Iwetter/Mimic-Animatronic-Head/renders/layers/PL01_layers.png

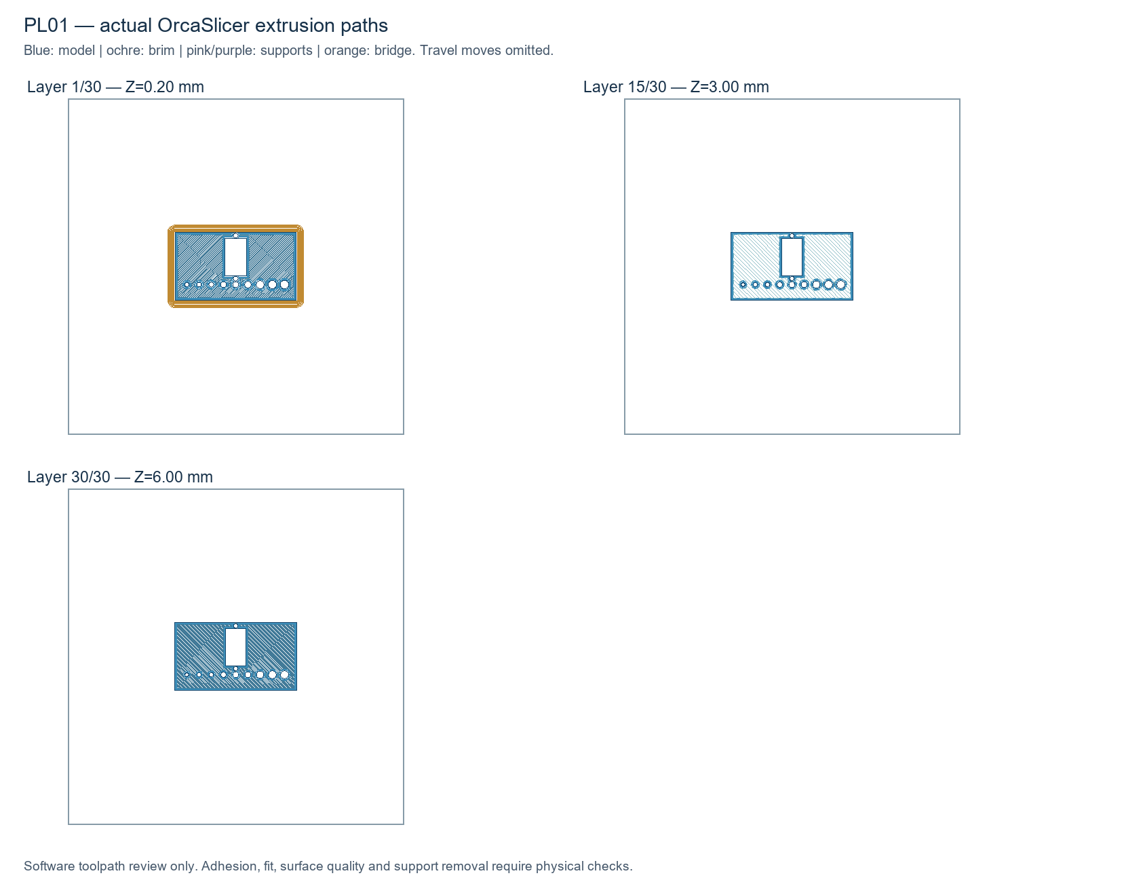
renders/layers/PL01_layers.png
