Iwetter/Mimic-Animatronic-Head/renders/layers/PL02_layers.png

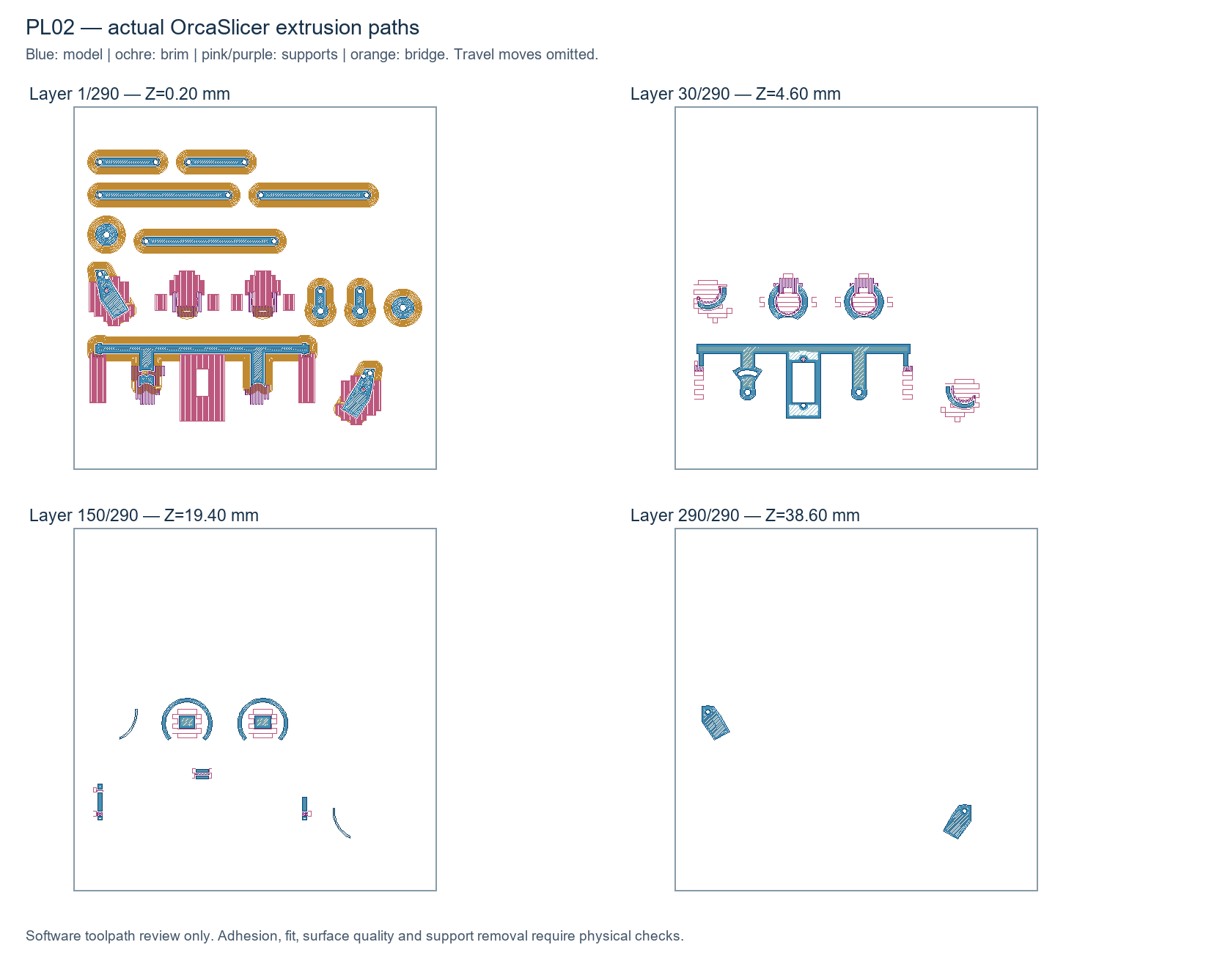
renders/layers/PL02_layers.png
