Iwetter/Mimic-Animatronic-Head/renders/layers/PL03_layers.png

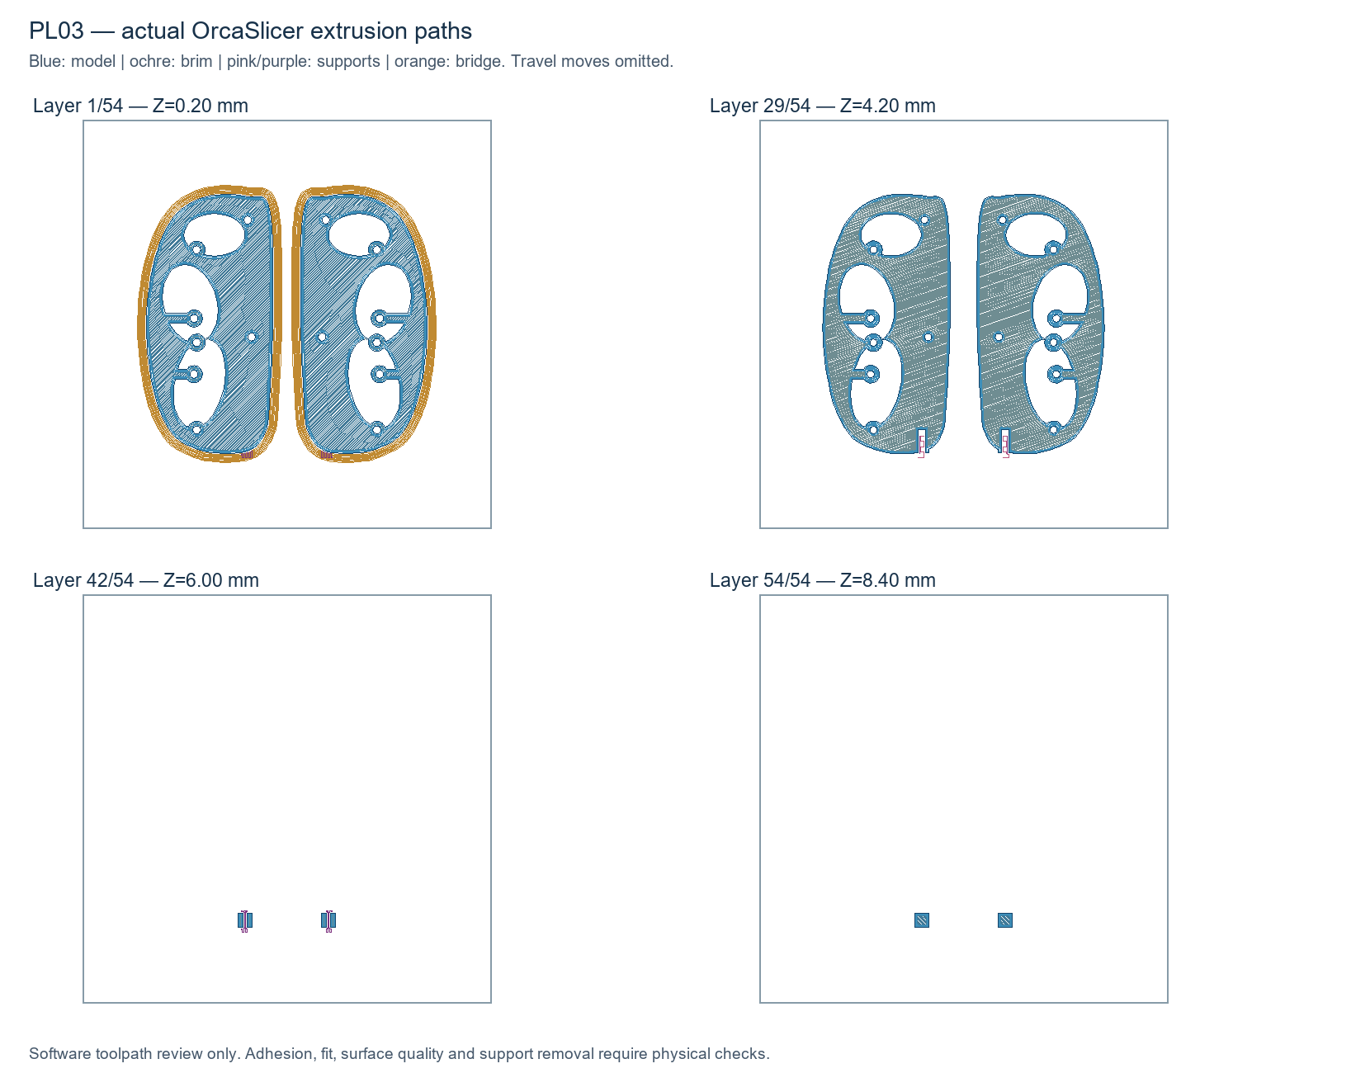
renders/layers/PL03_layers.png
