Iwetter/Mimic-Animatronic-Head/renders/layers/PL04_layers.png

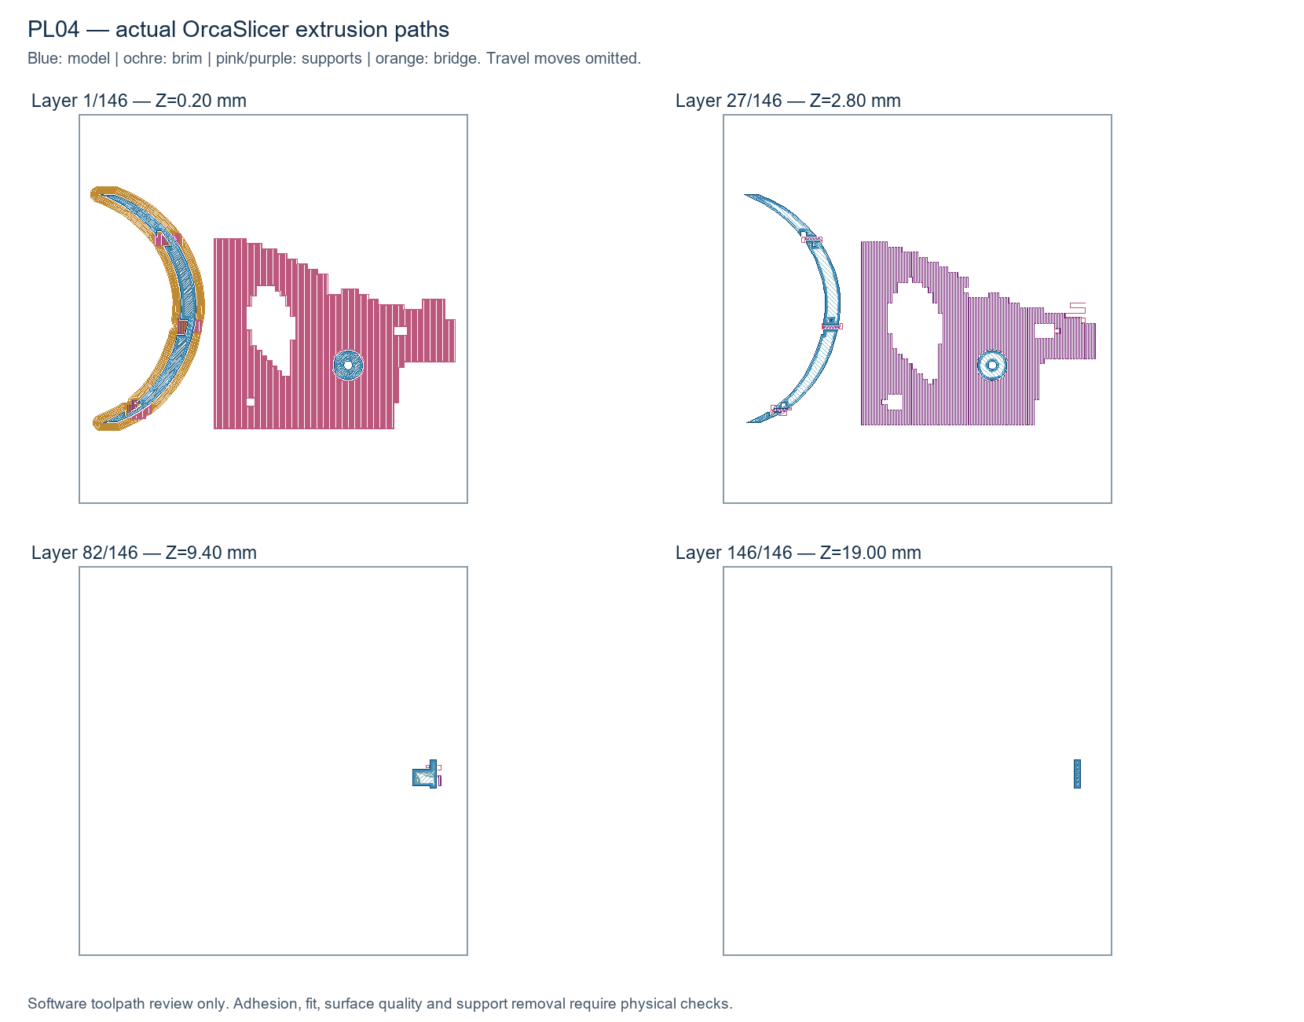
renders/layers/PL04_layers.png
