Iwetter/Mimic-Animatronic-Head/renders/layers/PL05_layers.png

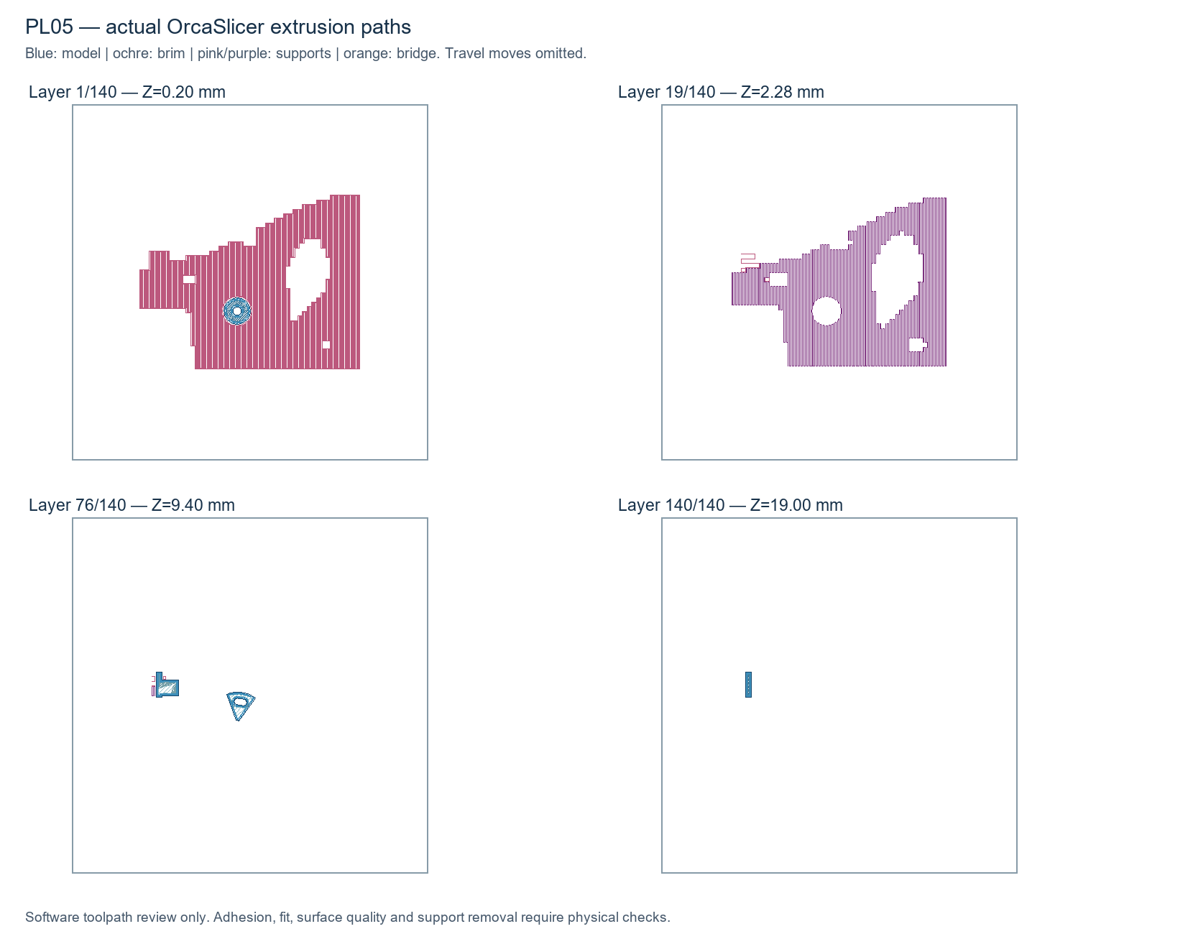
renders/layers/PL05_layers.png
