Iwetter/Mimic-Animatronic-Head/renders/layers/PL06_layers.png

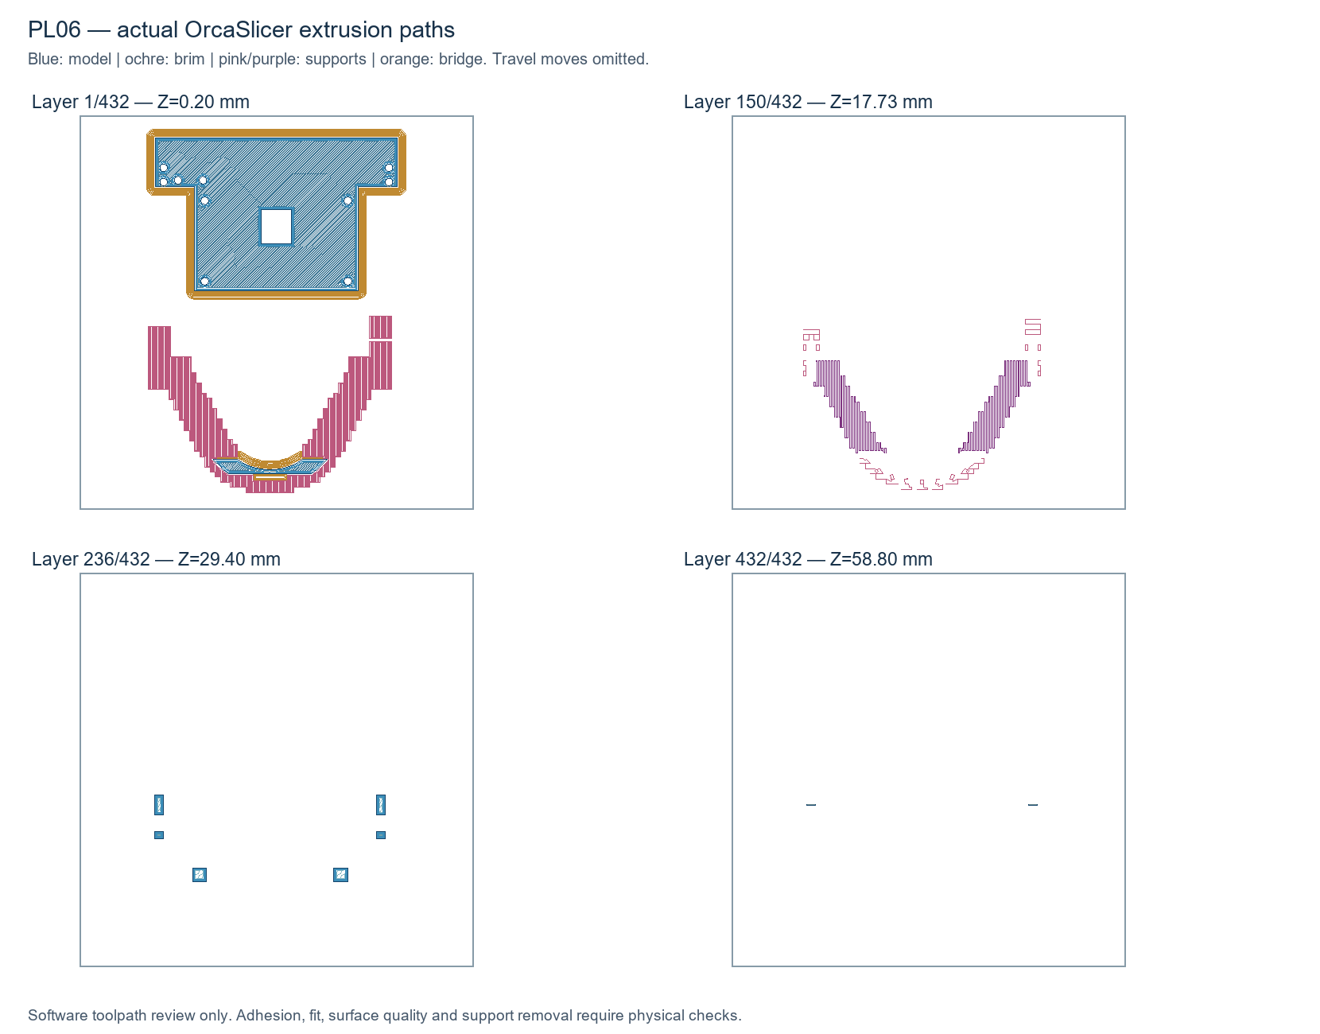
renders/layers/PL06_layers.png
