Iwetter/Mimic-Animatronic-Head/renders/layers/PL07_layers.png

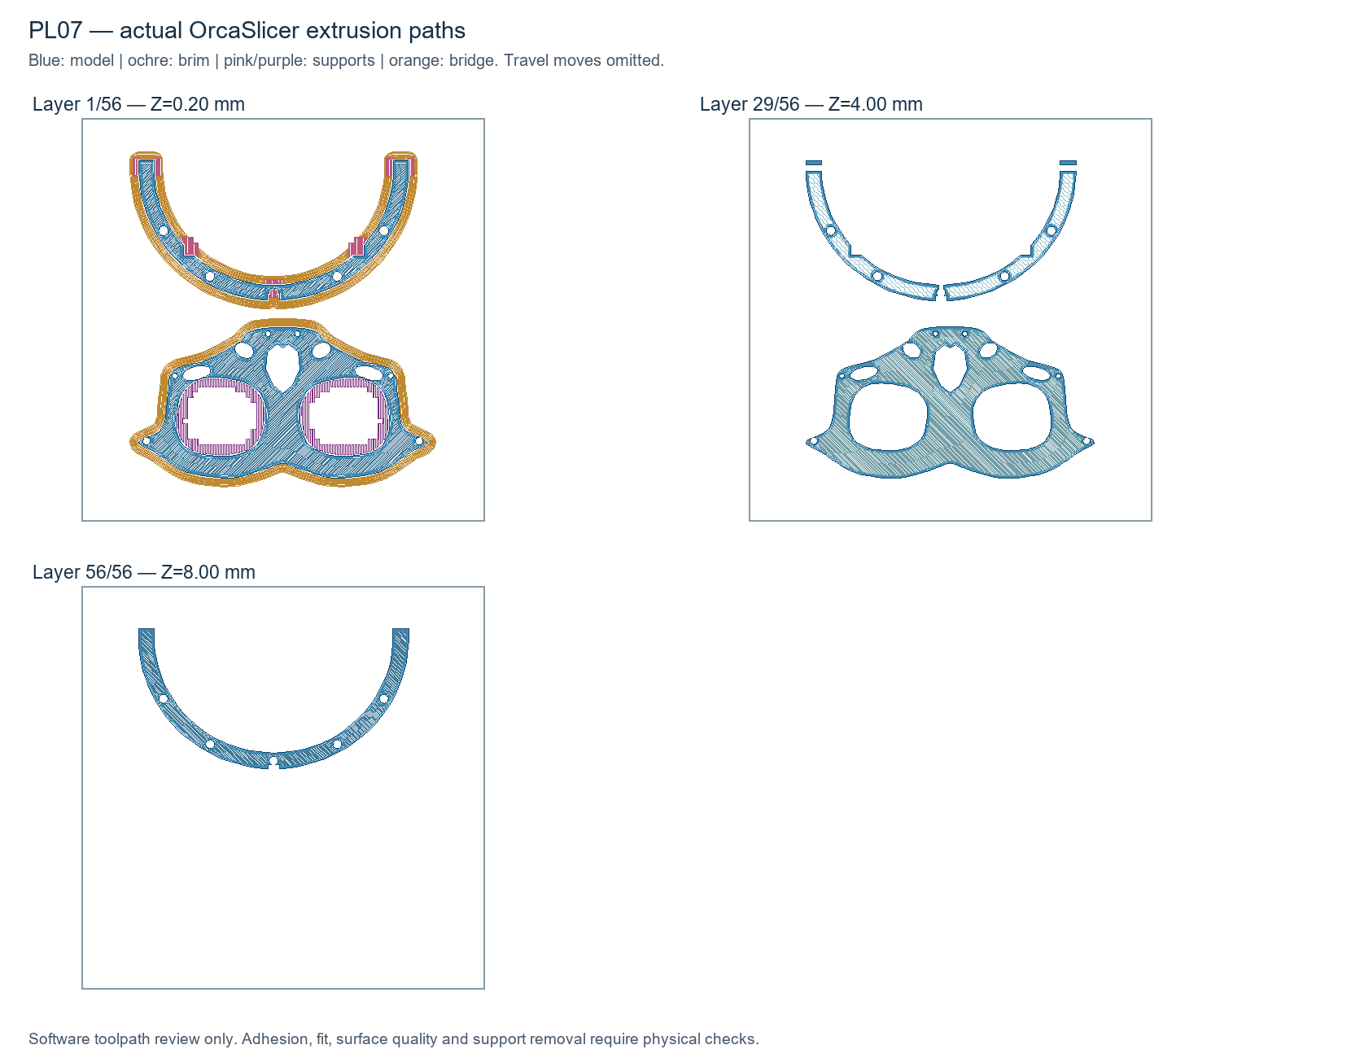
renders/layers/PL07_layers.png
