Iwetter/Mimic-Animatronic-Head/renders/layers/PL08_layers.png

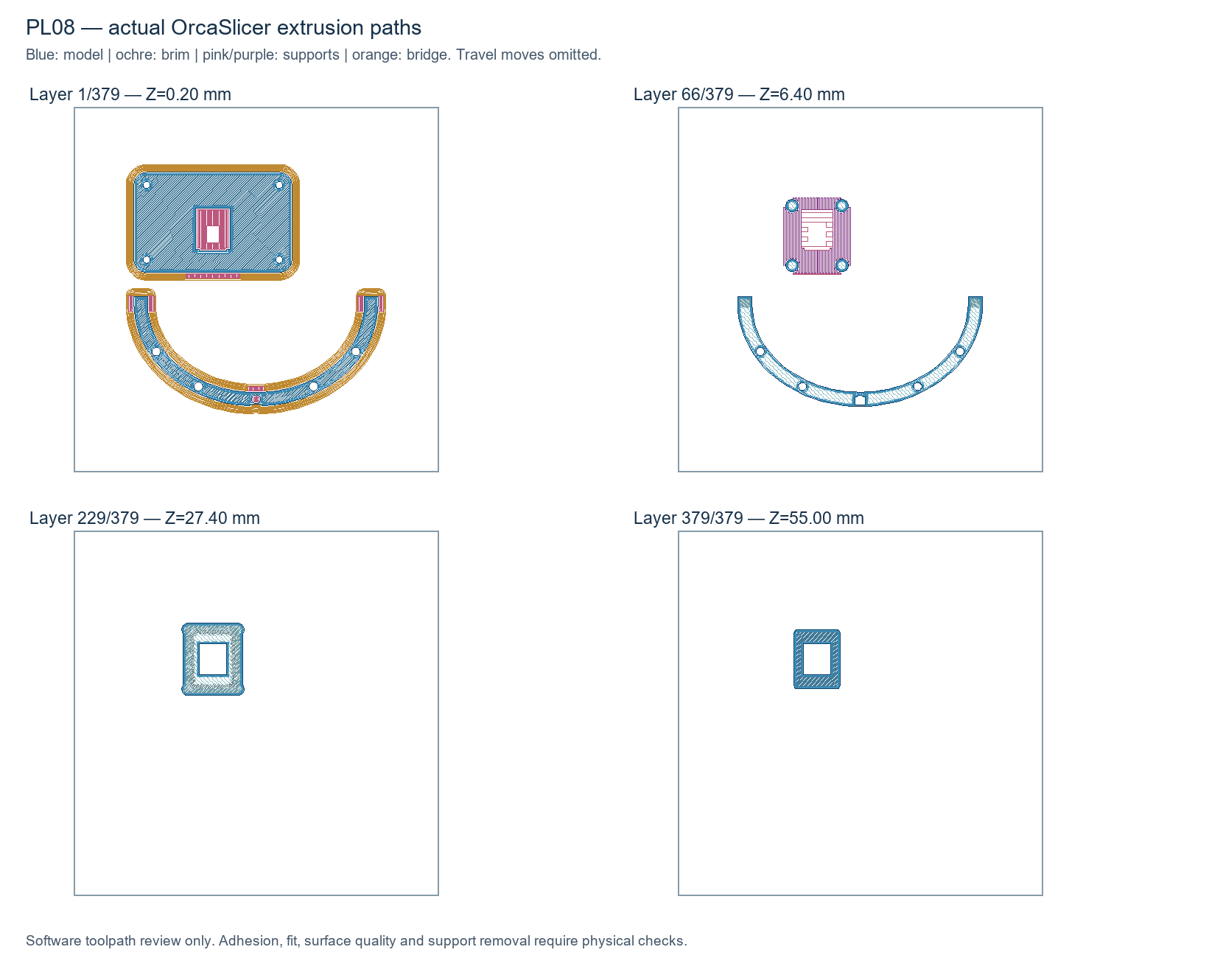
renders/layers/PL08_layers.png
