Iwetter/Mimic-Animatronic-Head/renders/layers/PL09_layers.png

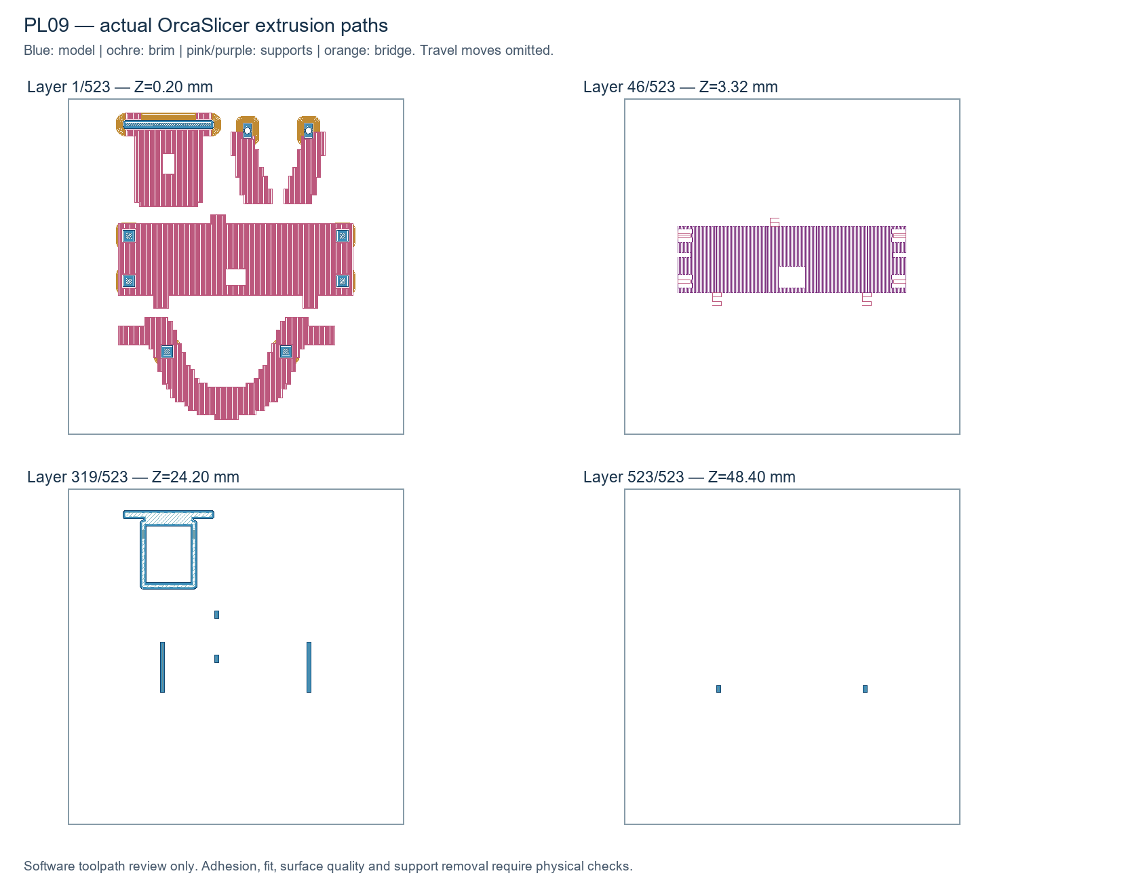
renders/layers/PL09_layers.png
