Iwetter/Mimic-Animatronic-Head/renders/layers/PL10_layers.png

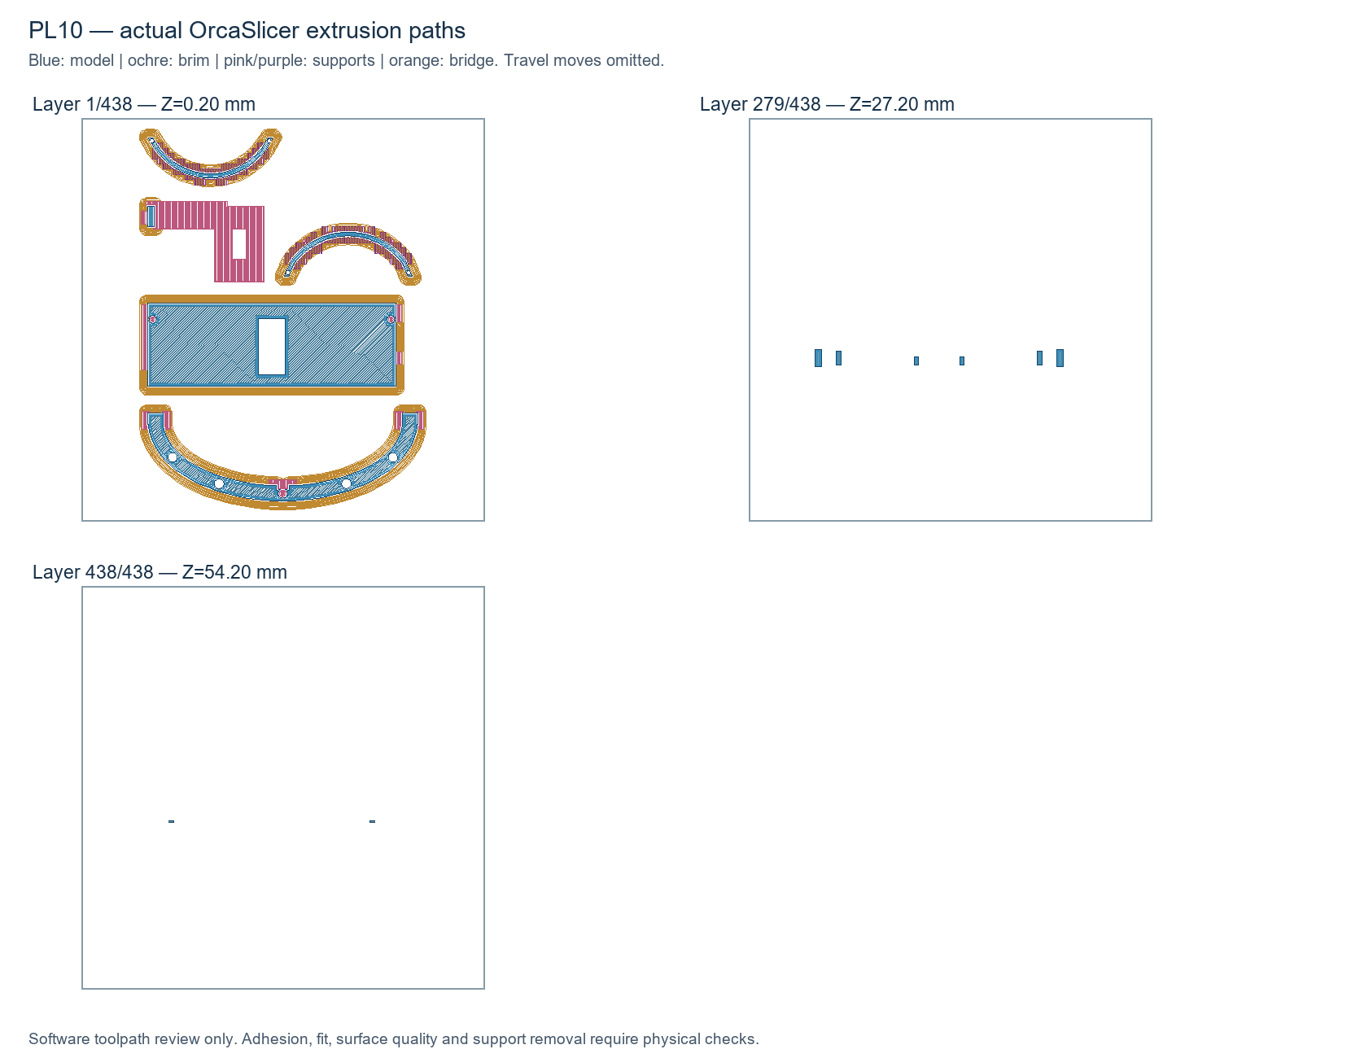
renders/layers/PL10_layers.png
