Iwetter/Mimic-Animatronic-Head/renders/mechanism_view.png

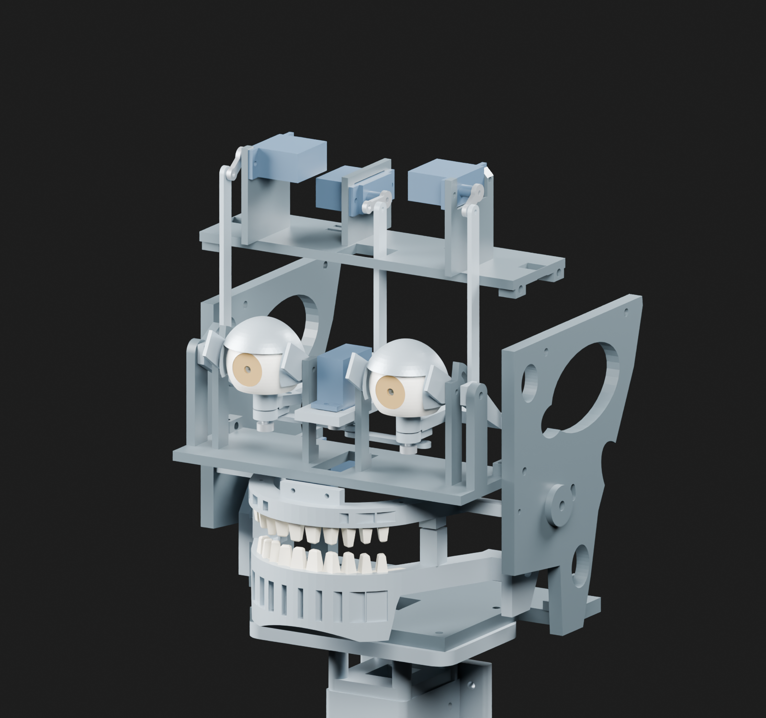
renders/mechanism_view.png
