Iwetter/Mimic-Animatronic-Head/variants/r4-m3-retrofit/preview/02_mechanism_rear.png

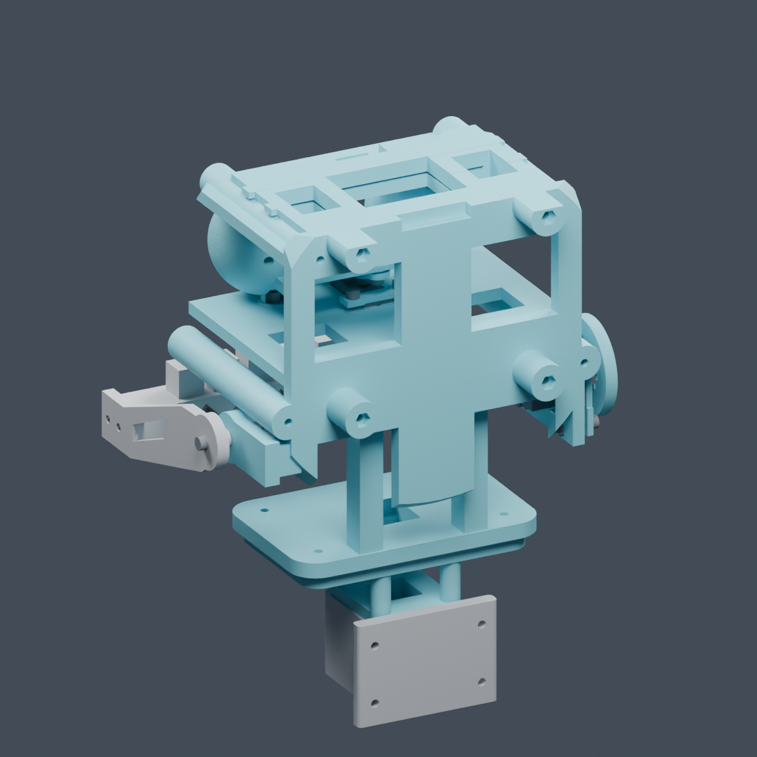
variants/r4-m3-retrofit/preview/02_mechanism_rear.png
