Iwetter/Mimic-Animatronic-Head/docs/physical_verification.csv

test_id | test | acceptance | evidence_required | status | build_serial | inspector | date | instrument | measured_result | evidence_reference | corrective_action
PV01 | Hardware identification | All five servo model numbers, voltage range, polarity and manufacturer data identified; actual supply voltage/current recorded. | Servo labels and datasheets; supply nameplate | NOT TESTED
PV02 | Mount and horn fit | Actual body/tab/shaft/horn/spline dimensions satisfy final CAD interface; OEM spline screw retained. | Caliper readings and photographs | NOT TESTED
PV03 | Print coupons | Measured holes/axles/nuts and running fits meet the chosen fit with no cracking or force-induced damage. | Coupon dimensions, process settings and photos | NOT TESTED
PV04 | Printed part integrity | All required IDs/quantities present; no cracks, warping, delamination or trapped supports in functional paths. | Inventory and visual inspection | NOT TESTED
PV05 | Mechanical retention | Every pivot is retained; each fastener has full nut engagement and tool access; joints rotate freely without axial clamp. | Fastener/axle inspection and service access photos | NOT TESTED
PV06 | Unpowered motion | Each axis and combined extreme poses clear structural/cosmetic surfaces, teeth and cables; stops contact as intended. | Measured clearances, angles and hand-motion video | NOT TESTED
PV07 | Neck and torso interface | Actual mating geometry fits preserved P01/P03; structural support and hardware grip verified for head-only bench use. | Measured socket/tenon and bolt patterns | NOT TESTED
PV08 | Electrical isolation and polarity | Correct fused distribution and common ground; no servo positive on 3V3; no short; speaker outputs isolated from GND. | Continuity and polarity readings | NOT TESTED
PV09 | Logic-only boot/reset | OE remains HIGH and pulses disabled during boot/reset/USB reconnect until explicit enable. | Scope traces with servo power OFF | NOT TESTED
PV10 | Detached servo response | All five detached servos respond consistently at verified voltage without excessive current/heat; neutral/direction identified. | Per-servo current, voltage and behavior | NOT TESTED
PV11 | PWM accuracy | Measured PCA period/pulses agree with calibration constants; oscillator corrected before endpoint measurement. | Scope measurements at neutral and adjacent commands | NOT TESTED
PV12 | One-axis calibration | Measured neutral/endpoints/angle/current/temperature recorded with margins before hard stops; axis limits entered. | firmware/calibration_record.csv and photos | NOT TESTED
PV13 | Combined calibrated envelope | All permitted combined axes and cable positions physically checked with margin; only then mechanical review gate accepted. | Corner-pose matrix and minimum clearances | NOT TESTED
PV14 | Disconnect and residual energy | Physical switch removes servo positive; capacitor decay measured; supported loads do not cause uncontrolled damage. | Voltage/time trace and observed behavior | NOT TESTED
PV15 | Timeout | Lease expiry disables OE after configured threshold; actual servo behavior and observed delay recorded. | Scope trace and supported-load video | NOT TESTED
PV16 | I2C fault | Controlled bus disconnect or loss faults to OE HIGH with no automatic restart. | Measured delay and fault log | NOT TESTED
PV17 | Reset and watchdog | Controlled reset/watchdog leaves OE disabled and requires explicit recovery; load remains supported. | Scope trace and recovery log | NOT TESTED
PV18 | Supply transient and drop | Approved peak demand causes acceptable servo-terminal voltage and no logic resets; conductor/connector/fuse ratings justified. | Rail scope traces, currents and sizing record | NOT TESTED
PV19 | Thermal and 100-cycle screen | Supervised low-excursion run shows no rising abnormal temperature, loosening, cracks, rubbing or cable wear. | Cycle count, temperatures, current and inspection notes | NOT TESTED
PV20 | Moving mass and neck load | Measured assembly mass/COM and loads recorded; active neck/full-body use remains separately engineered. | Scale readings and COM/load record | NOT TESTED
PV21 | Voice integration | Original voice source obtained, reviewed, compiled and tested with reserved pins and motion timing under audio load. | Source identity, build logs and live audio/motion test | NOT TESTED
