Iwetter/Mimic-Animatronic-Head/stl_backup/P49_lid_pushrod.stl

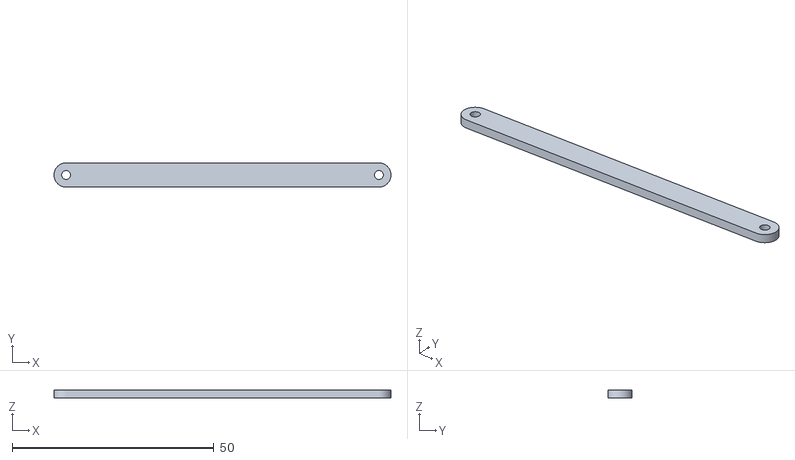
[picture p25: CAD file, 2026-10-22]
stl_backup/P49_lid_pushrod.stl
83.6 x 6.00 x 2.00
