Iwetter/Mimic-Animatronic-Head/variants/r4-m3-retrofit/FIT_TEST_FIRST/T02_horn_fit_lower_PRINT_1.stl

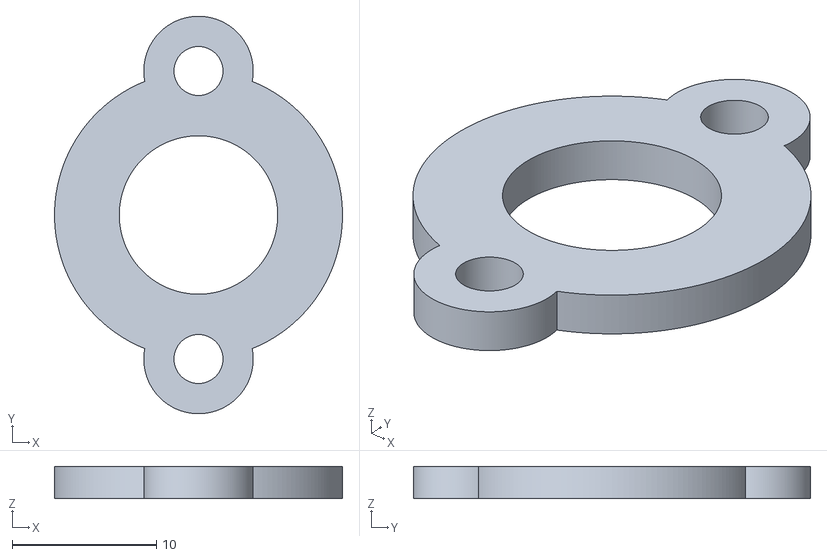
[picture p26: CAD file, 2026-11-07]
variants/r4-m3-retrofit/FIT_TEST_FIRST/T02_horn_fit_lower_PRINT_1.stl
20.0 x 27.6 x 2.25
