Iwetter/Mimic-Animatronic-Head/variants/r4-m3-retrofit/PRINT_PLATES_3MF/01_NECK.3mf

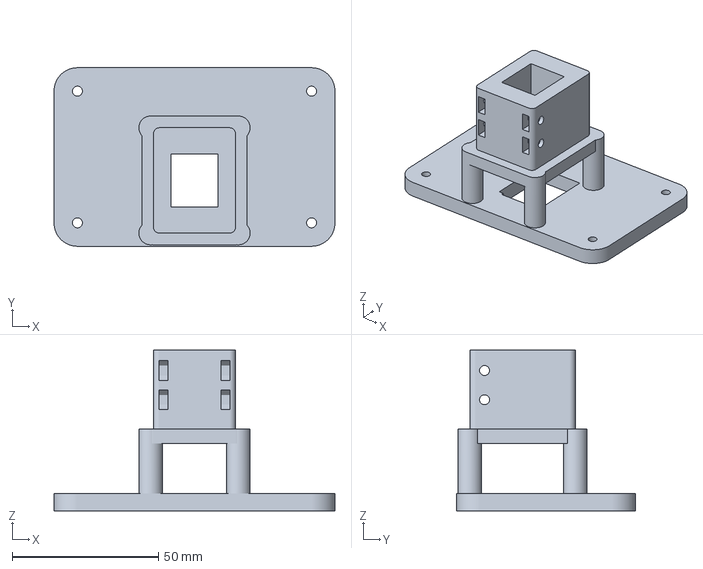
[picture p27: CAD file, 2026-11-07]
variants/r4-m3-retrofit/PRINT_PLATES_3MF/01_NECK.3mf
96.0 x 61.0 x 55.0 mm
