Iwetter/Mimic-Animatronic-Head/variants/r4-m3-retrofit/reference_R4/STEP/parts/P07_MG90S_eye_adapter.step

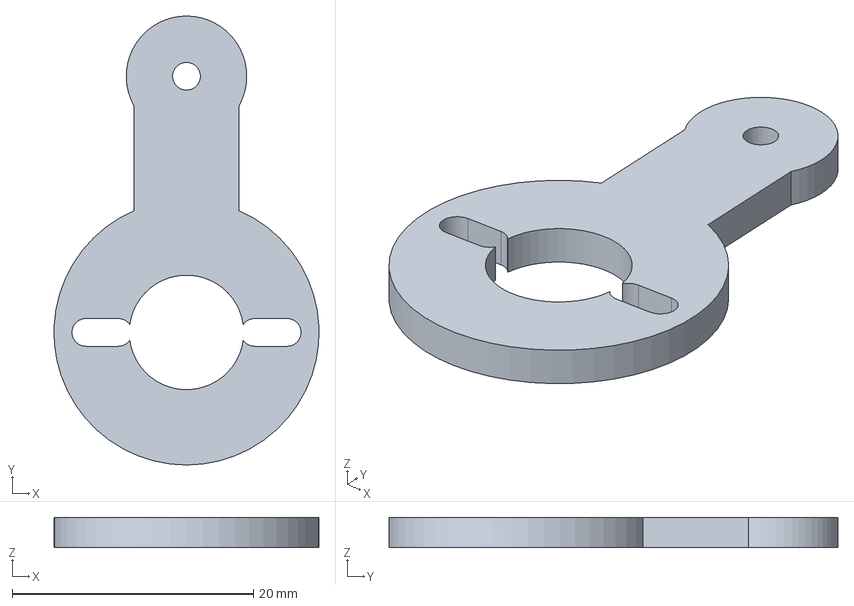
[picture p28: CAD file, 2026-11-07]
variants/r4-m3-retrofit/reference_R4/STEP/parts/P07_MG90S_eye_adapter.step
22.0 x 37.2 x 2.50 mm
