Iwetter/Mimic-Animatronic-Head/variants/r4-m3-retrofit/REUSED_R4_STL/P13_open_rear_cranium_truss.stl

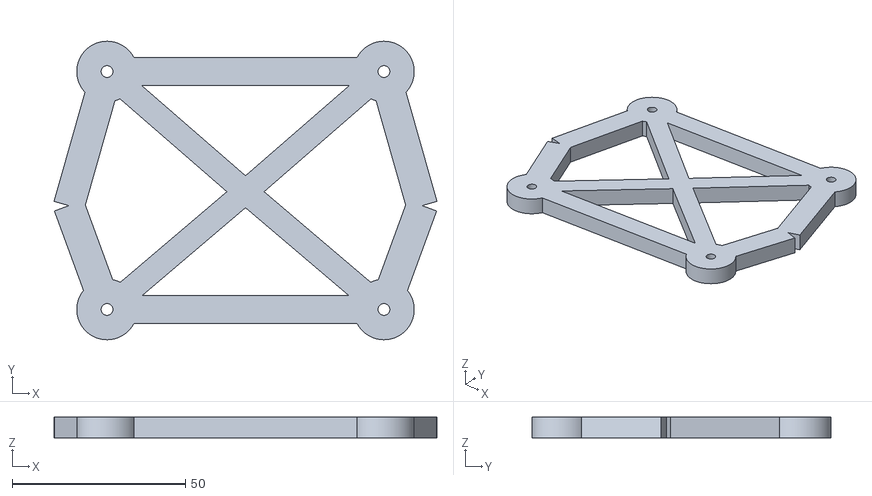
[picture p29: CAD file, 2026-11-07]
variants/r4-m3-retrofit/REUSED_R4_STL/P13_open_rear_cranium_truss.stl
110.7 x 86.2 x 6.00
