Iwetter/Mimic-Animatronic-Head/variants/r4-m3-retrofit/STEP/P05_short_pin_eye.step

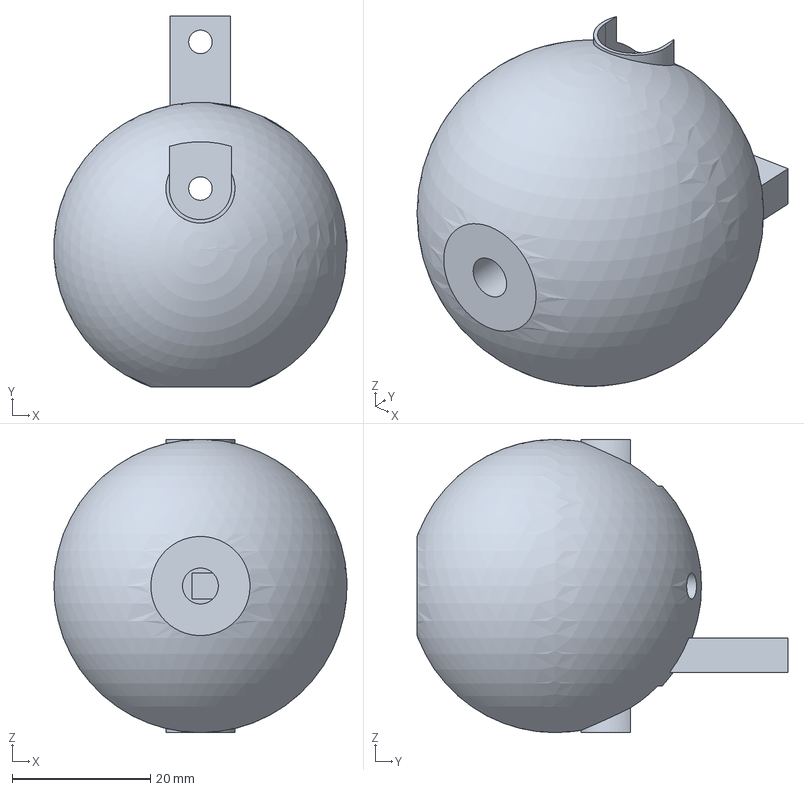
[picture p30: CAD file, 2026-11-07]
variants/r4-m3-retrofit/STEP/P05_short_pin_eye.step
42.4 x 53.8 x 42.5 mm
