Iwetter/Mimic-Animatronic-Head/stl_backup/P21_lower_wall_L.stl

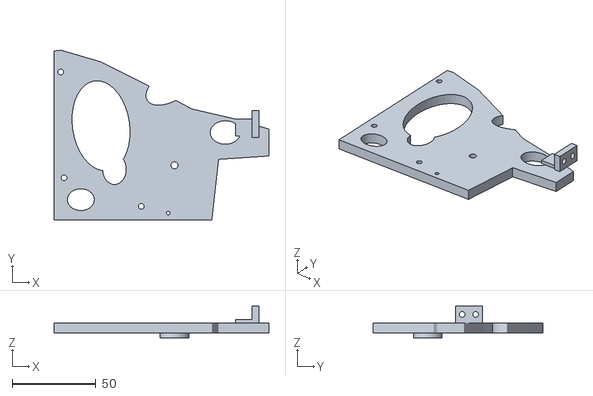
[picture p31: CAD file, 2026-10-22]
stl_backup/P21_lower_wall_L.stl
128.0 x 101.0 x 19.0
