Iwetter/Mimic-Animatronic-Head/variants/r4-m3-retrofit/assembly_meshes/A03_jaw_4.stl

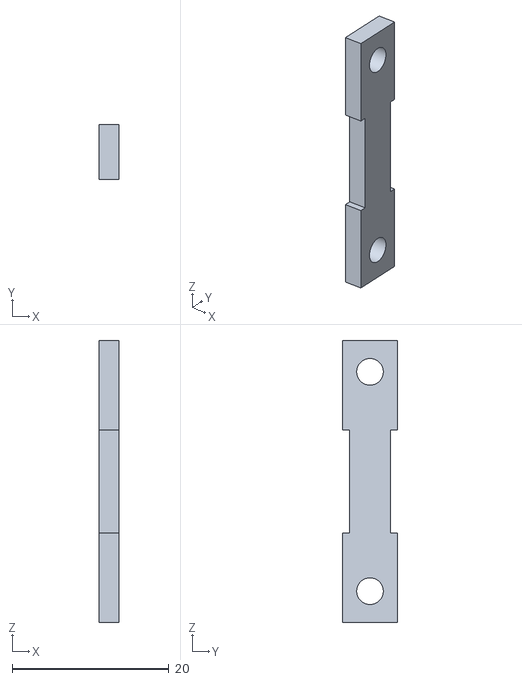
[picture p32: CAD file, 2026-11-07]
variants/r4-m3-retrofit/assembly_meshes/A03_jaw_4.stl
2.50 x 7.00 x 36.0
