Iwetter/Mimic-Animatronic-Head/variants/r4-m3-retrofit/FIT_TEST_FIRST/T03_servo_tab_fit_base_PRINT_1.stl

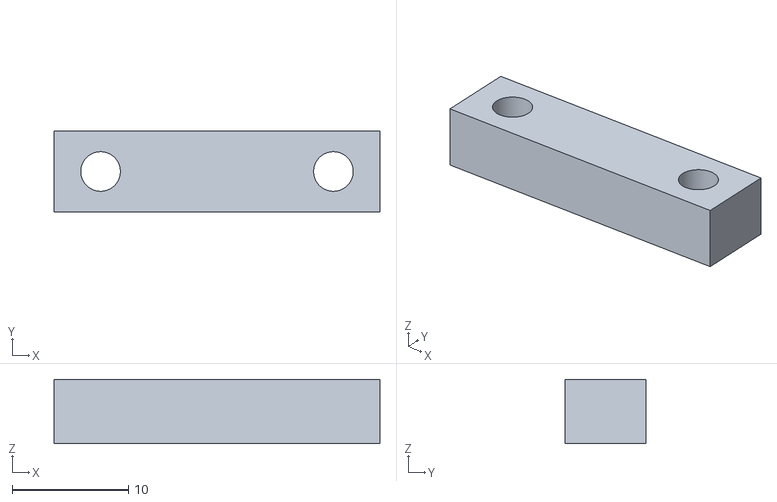
[picture p33: CAD file, 2026-11-07]
variants/r4-m3-retrofit/FIT_TEST_FIRST/T03_servo_tab_fit_base_PRINT_1.stl
28.0 x 7.00 x 5.50
