Iwetter/Mimic-Animatronic-Head/variants/r4-m3-retrofit/PRINT_PLATES_3MF/05_LEFT_JAW.3mf

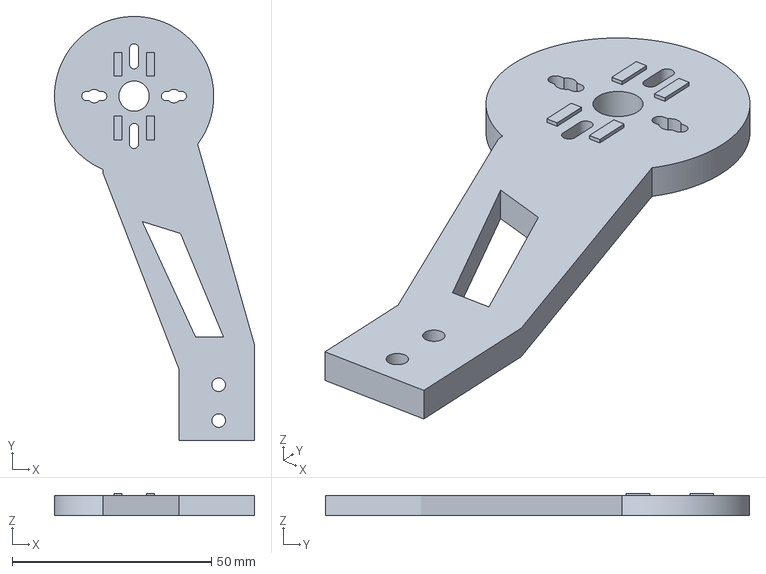
[picture p34: CAD file, 2026-11-07]
variants/r4-m3-retrofit/PRINT_PLATES_3MF/05_LEFT_JAW.3mf
50.2 x 106.5 x 5.60 mm
