Iwetter/Mimic-Animatronic-Head/variants/r4-m3-retrofit/reference_R4/STEP/parts/P01_torso_spine_socket.step

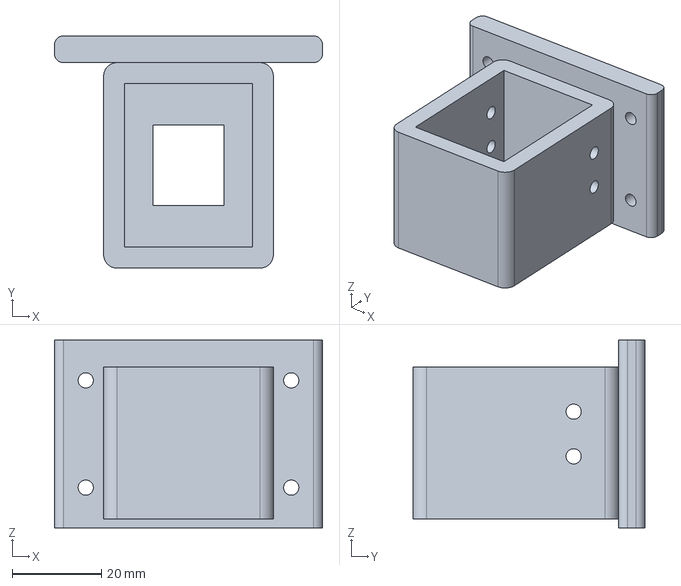
[picture p35: CAD file, 2026-11-07]
variants/r4-m3-retrofit/reference_R4/STEP/parts/P01_torso_spine_socket.step
60.0 x 52.0 x 42.0 mm
