Iwetter/Mimic-Animatronic-Head/variants/r4-m3-retrofit/REUSED_R4_STL/P09_jaw_spacer.stl

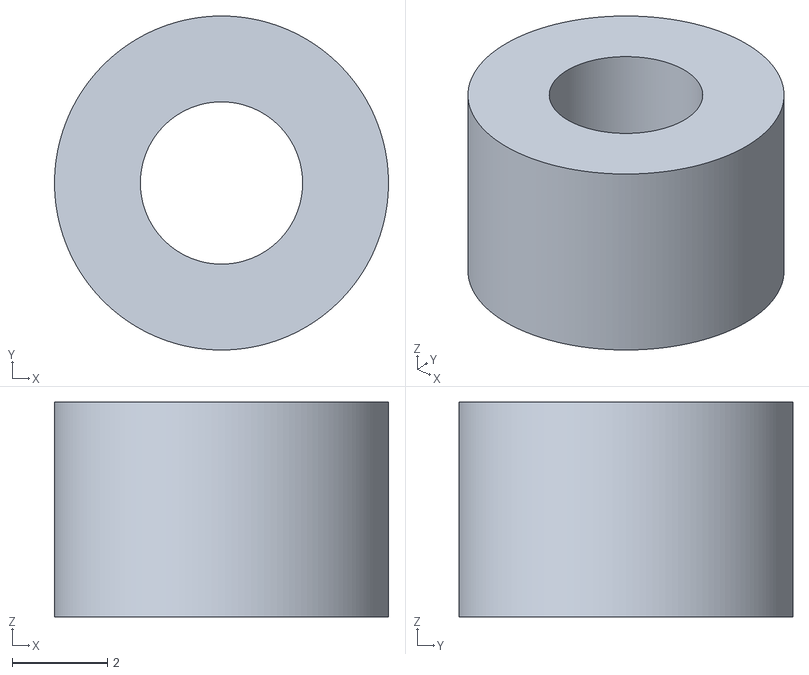
[picture p36: CAD file, 2026-11-07]
variants/r4-m3-retrofit/REUSED_R4_STL/P09_jaw_spacer.stl
7.00 x 7.00 x 4.50
