Iwetter/Mimic-Animatronic-Head/variants/r4-m3-retrofit/STEP/P10_eye_thrust_ring.step

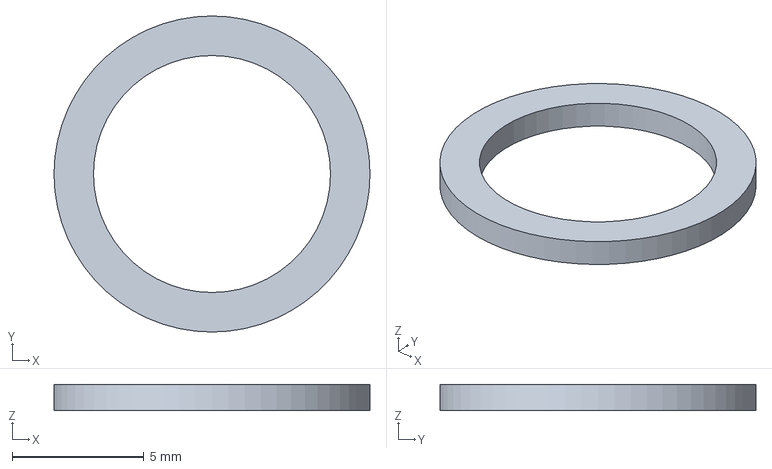
[picture p37: CAD file, 2026-11-07]
variants/r4-m3-retrofit/STEP/P10_eye_thrust_ring.step
12.0 x 12.0 x 1.00 mm
