Iwetter/Mimic-Animatronic-Head/stl_backup/P25_cranial_arch_front.stl

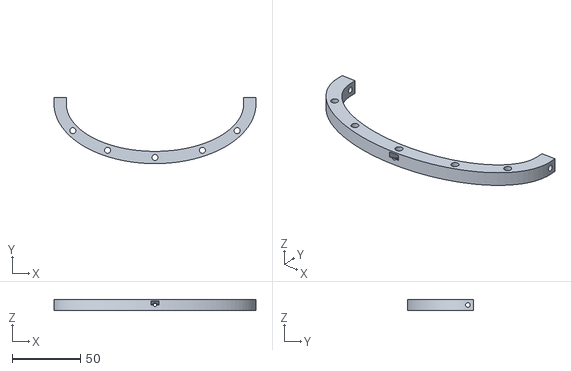
[picture p38: CAD file, 2026-10-22]
stl_backup/P25_cranial_arch_front.stl
148.0 x 48.5 x 8.00
