Iwetter/Mimic-Animatronic-Head/variants/r4-m3-retrofit/assembly_meshes/A01_eye_-36.stl

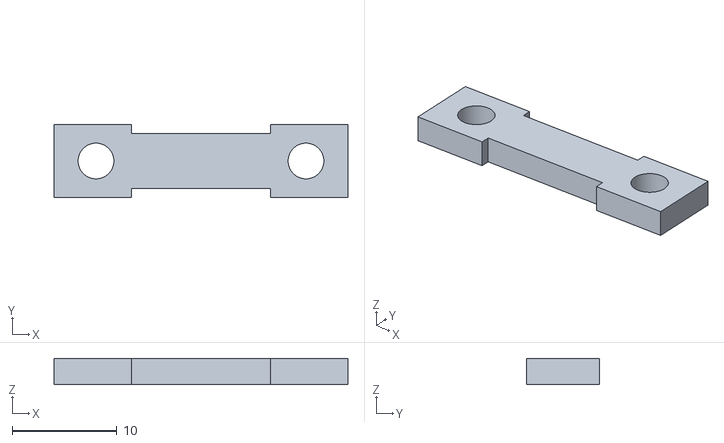
[picture p39: CAD file, 2026-11-07]
variants/r4-m3-retrofit/assembly_meshes/A01_eye_-36.stl
28.0 x 7.00 x 2.50
