Iwetter/Mimic-Animatronic-Head/variants/r4-m3-retrofit/FIT_TEST_FIRST/T01_horn_fit_upper_PRINT_1.stl

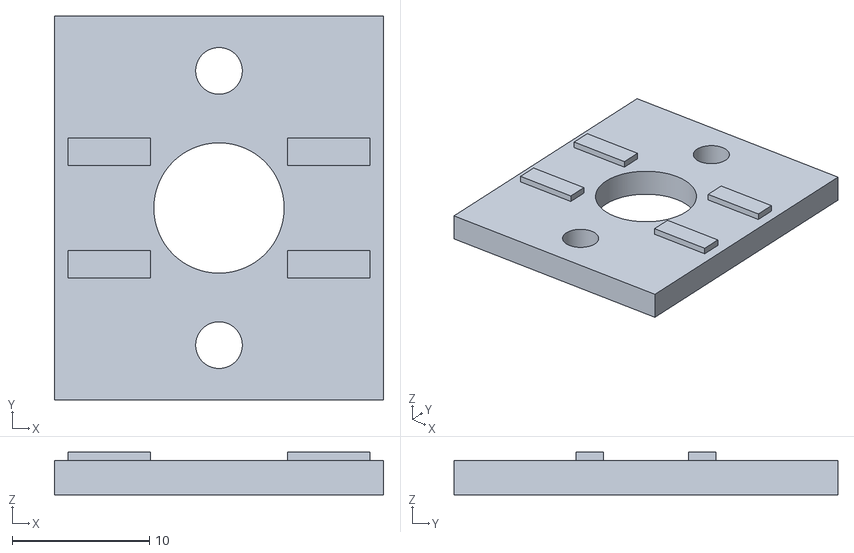
[picture p40: CAD file, 2026-11-07]
variants/r4-m3-retrofit/FIT_TEST_FIRST/T01_horn_fit_upper_PRINT_1.stl
24.0 x 28.0 x 3.10
