Iwetter/Mimic-Animatronic-Head/variants/r4-m3-retrofit/PRINT_PLATES_3MF/04_EYE_LINK.3mf

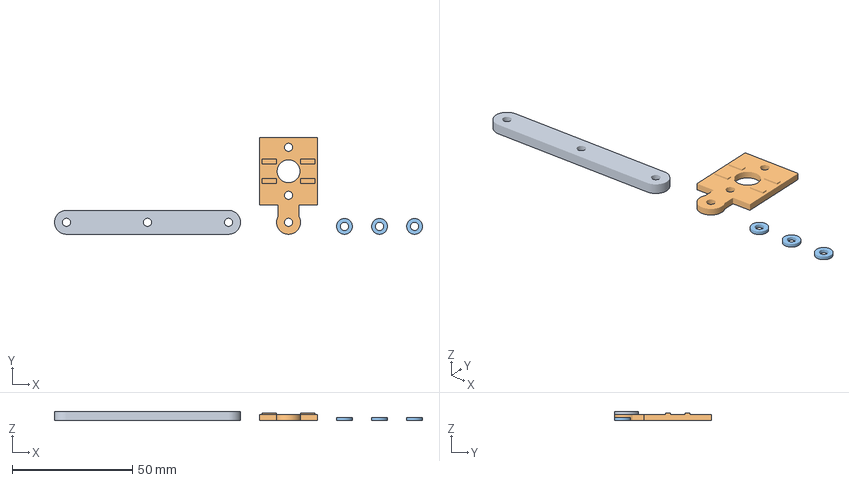
[picture p41: CAD file, 2026-11-07]
variants/r4-m3-retrofit/PRINT_PLATES_3MF/04_EYE_LINK.3mf
153.3 x 40.2 x 3.75 mm
P06 M3_eye_link
P07 eye_horn_sandwich
P11 M3_link_washer x 3
