Iwetter/Mimic-Animatronic-Head/variants/r4-m3-retrofit/reference_R4/STEP/parts/P06_large_eye_link.step

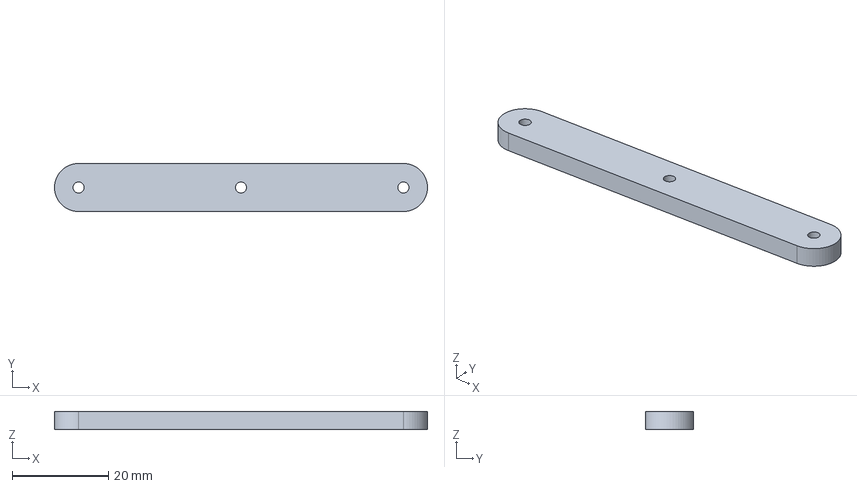
[picture p42: CAD file, 2026-11-07]
variants/r4-m3-retrofit/reference_R4/STEP/parts/P06_large_eye_link.step
77.5 x 10.0 x 3.75 mm
