Iwetter/Mimic-Animatronic-Head/variants/r4-m3-retrofit/REUSED_R4_STL/P18_jaw_right_idler_arm.stl

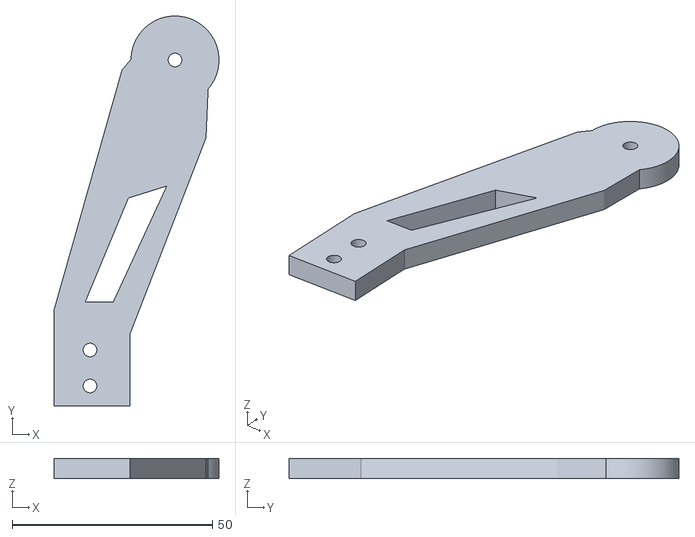
[picture p43: CAD file, 2026-11-07]
variants/r4-m3-retrofit/REUSED_R4_STL/P18_jaw_right_idler_arm.stl
41.2 x 97.5 x 5.00
