Iwetter/Mimic-Animatronic-Head/stl_backup/P30_zygoma_L.stl

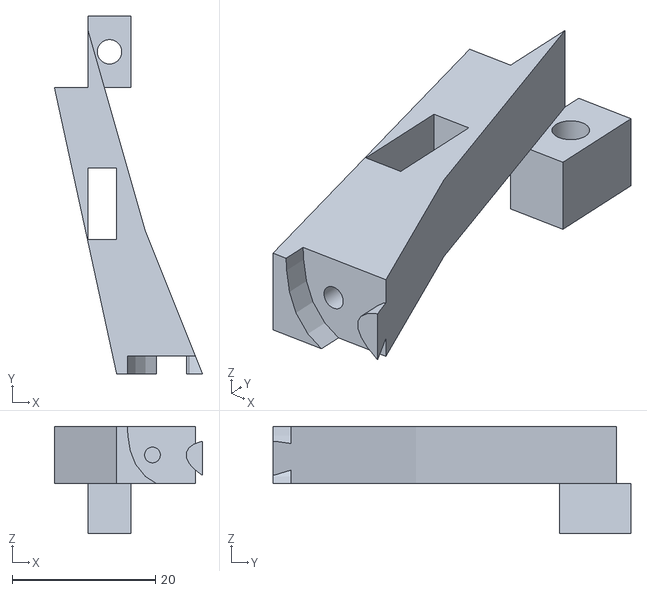
[picture p44: CAD file, 2026-10-22]
stl_backup/P30_zygoma_L.stl
20.7 x 50.0 x 15.0
