Iwetter/Mimic-Animatronic-Head/variants/r4-m3-retrofit/assembly_meshes/neck_head(-22, -48).stl

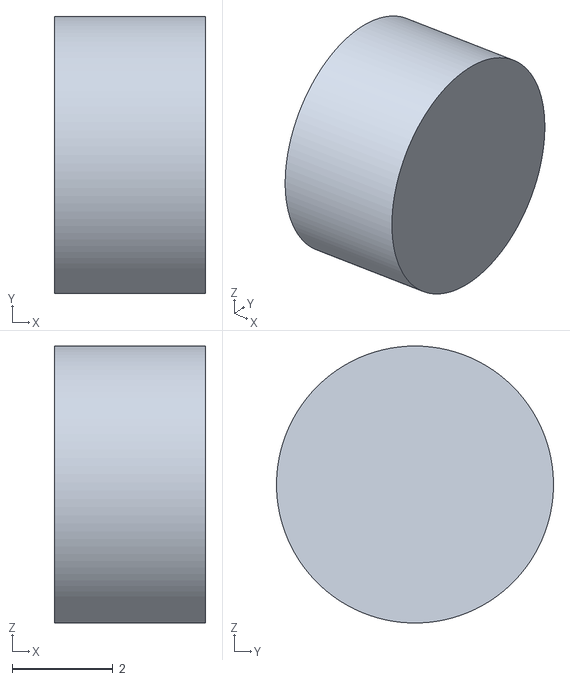
[picture p45: CAD file, 2026-11-07]
variants/r4-m3-retrofit/assembly_meshes/neck_head(-22, -48).stl
3.00 x 5.50 x 5.50
