Iwetter/Mimic-Animatronic-Head/variants/r4-m3-retrofit/PRINT_PLATES_3MF/06_CLAMPS.3mf

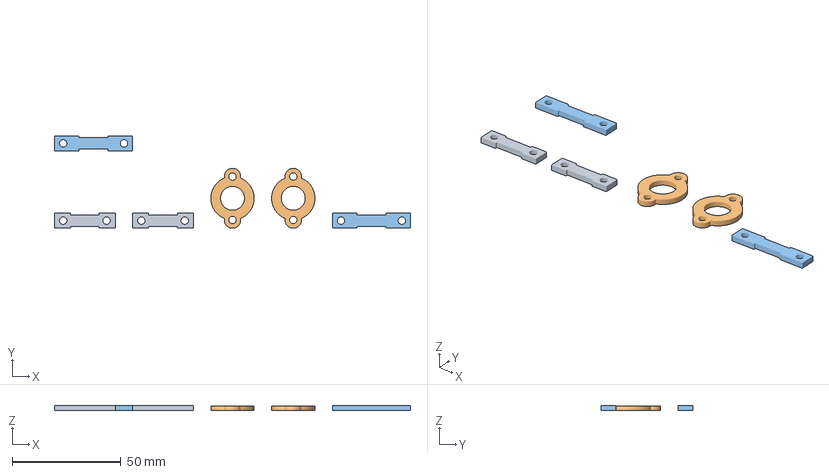
[picture p46: CAD file, 2026-11-07]
variants/r4-m3-retrofit/PRINT_PLATES_3MF/06_CLAMPS.3mf
164.0 x 42.6 x 2.50 mm
A01 eye_servo_tab_bridge x 2
A02 horn_clamp_plate x 2
A03 jaw_servo_tab_bridge x 2
