Iwetter/Mimic-Animatronic-Head/variants/r4-m3-retrofit/reference_R4/STEP/parts/P15_concentric_LED_iris.step

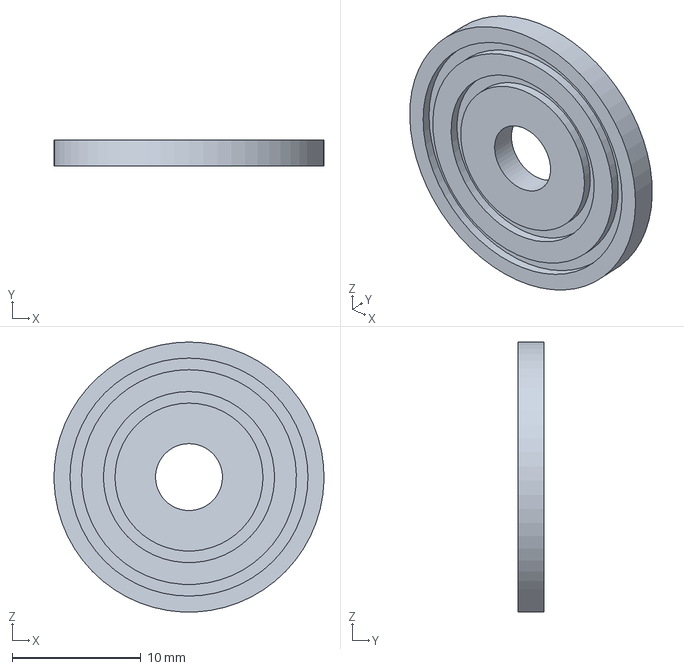
[picture p47: CAD file, 2026-11-07]
variants/r4-m3-retrofit/reference_R4/STEP/parts/P15_concentric_LED_iris.step
21.0 x 2.00 x 21.0 mm
