Iwetter/Mimic-Animatronic-Head/variants/r4-m3-retrofit/STL_REPRINT/P05_short_pin_eye_PRINT_2.stl

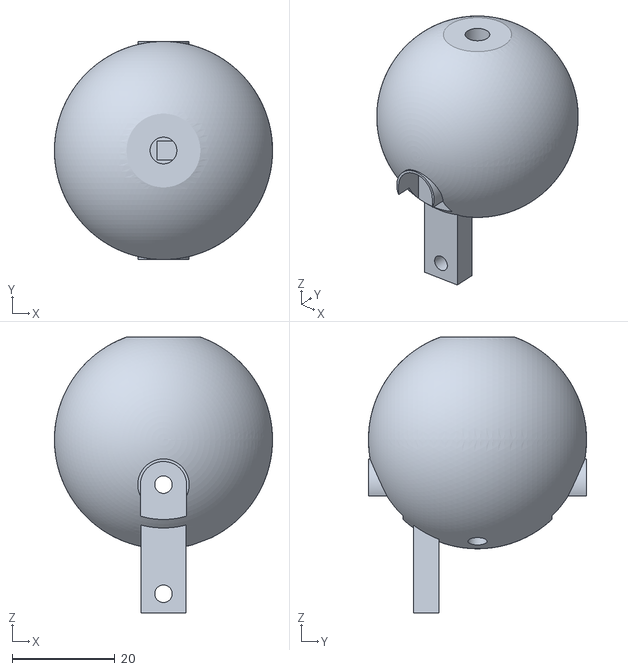
[picture p48: CAD file, 2026-11-07]
variants/r4-m3-retrofit/STL_REPRINT/P05_short_pin_eye_PRINT_2.stl
42.5 x 42.5 x 53.8
