Iwetter/Mimic-Animatronic-Head/stl_backup/P41_mechanism_deck.stl

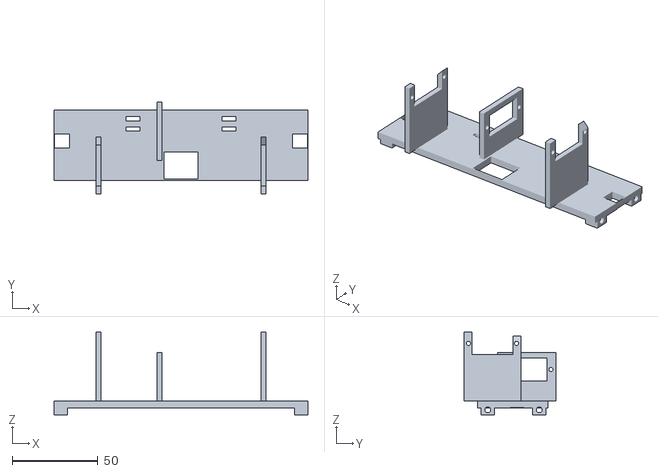
[picture p49: CAD file, 2026-10-22]
stl_backup/P41_mechanism_deck.stl
148.0 x 53.6 x 48.3
