Iwetter/Mimic-Animatronic-Head/variants/r4-m3-retrofit/PRINT_PLATES_3MF/03_EYES.3mf

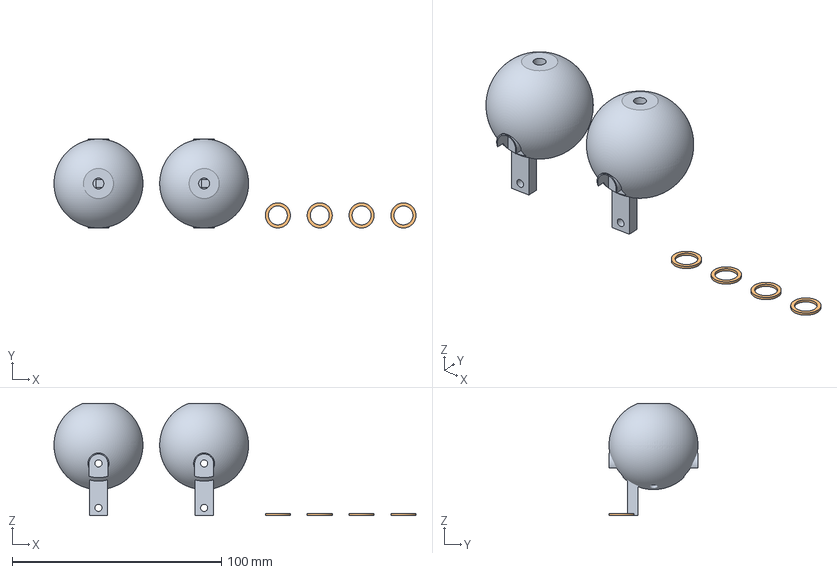
[picture p50: CAD file, 2026-11-07]
variants/r4-m3-retrofit/PRINT_PLATES_3MF/03_EYES.3mf
173.0 x 42.5 x 53.8 mm
P05 short_pin_eye x 2
P10 eye_thrust_ring x 4
