Iwetter/Mimic-Animatronic-Head/variants/r4-m3-retrofit/reference_R4/STEP/parts/P04_endoskeleton_chassis.step

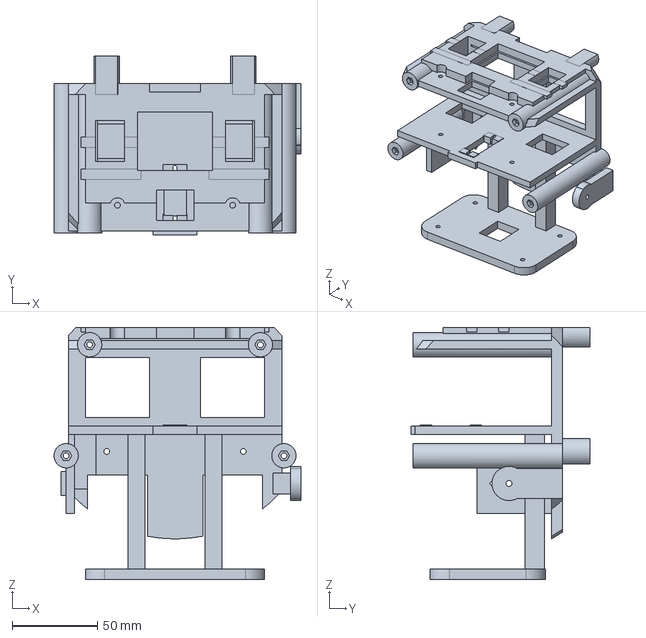
[picture p51: CAD file, 2026-11-07]
variants/r4-m3-retrofit/reference_R4/STEP/parts/P04_endoskeleton_chassis.step
144.6 x 105.0 x 147.6 mm
