Iwetter/Mimic-Animatronic-Head/variants/r4-m3-retrofit/REUSED_R4_STL/P19_lower_teeth_bridge.stl

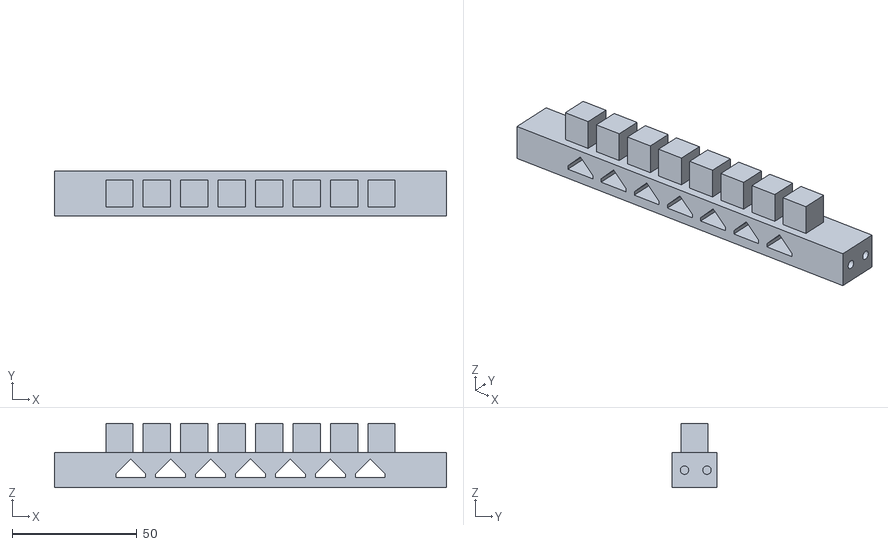
[picture p52: CAD file, 2026-11-07]
variants/r4-m3-retrofit/REUSED_R4_STL/P19_lower_teeth_bridge.stl
157.1 x 18.0 x 25.8
