Iwetter/Mimic-Animatronic-Head/stl_backup/P33_mandible.stl

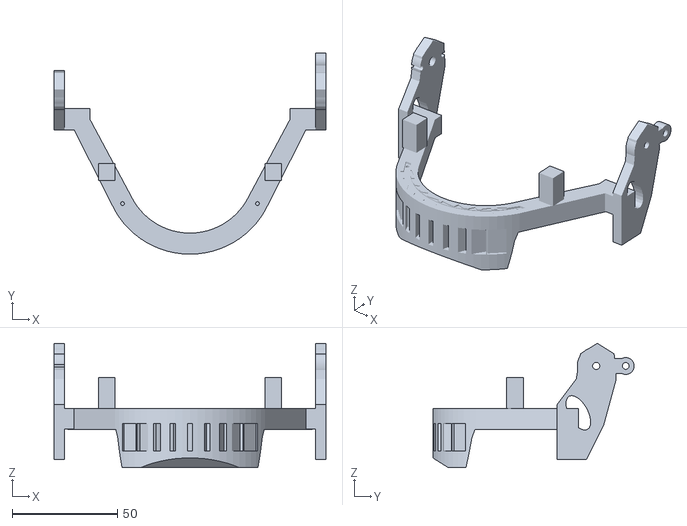
[picture p53: CAD file, 2026-10-22]
stl_backup/P33_mandible.stl
129.0 x 95.5 x 59.0
