Iwetter/Mimic-Animatronic-Head/variants/r4-m3-retrofit/PRINT_PLATES_3MF/00_FIT_TEST_FIRST.3mf

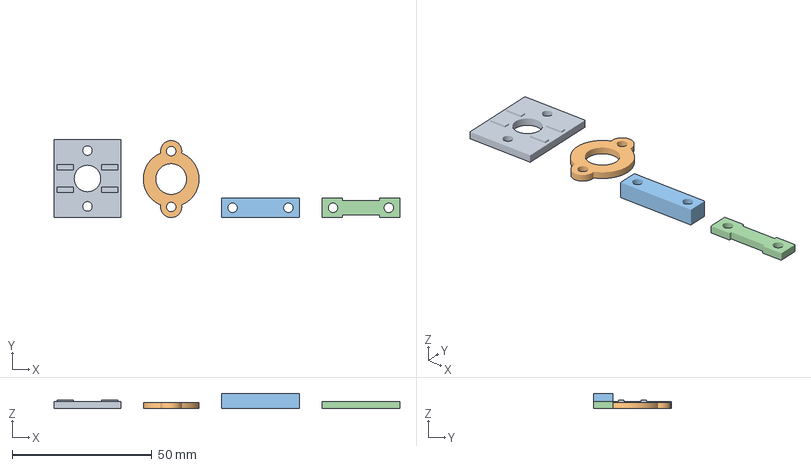
[picture p54: CAD file, 2026-11-07]
variants/r4-m3-retrofit/PRINT_PLATES_3MF/00_FIT_TEST_FIRST.3mf
124.0 x 28.0 x 5.50 mm
T01 horn_fit_upper
T02 horn_fit_lower
T03 servo_tab_fit_base
T04 servo_tab_fit_bridge
