Iwetter/Mimic-Animatronic-Head/variants/r4-m3-retrofit/REUSED_R4_STL/P12_skeletal_brow_and_upper_teeth.stl

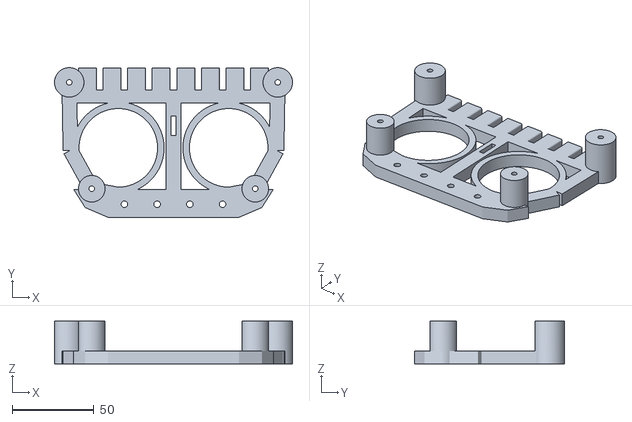
[picture p55: CAD file, 2026-11-07]
variants/r4-m3-retrofit/REUSED_R4_STL/P12_skeletal_brow_and_upper_teeth.stl
145.5 x 91.5 x 26.2
