Iwetter/Mimic-Animatronic-Head/stl_backup/P35_iris_insert.stl

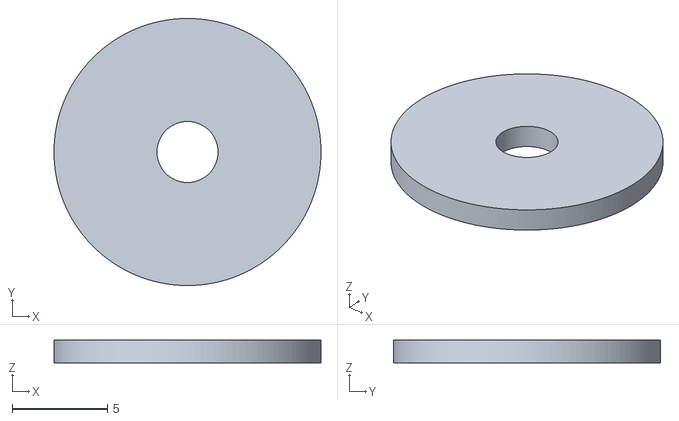
[picture p56: CAD file, 2026-10-22]
stl_backup/P35_iris_insert.stl
14.0 x 14.0 x 1.20
