Iwetter/Mimic-Animatronic-Head/stl_backup/P26_cranial_arch_mid.stl

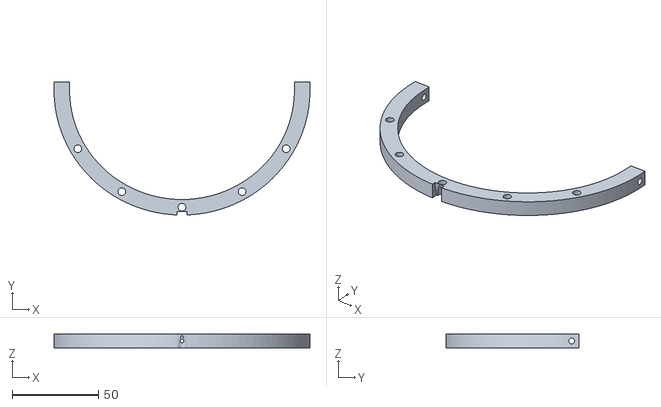
[picture p57: CAD file, 2026-10-22]
stl_backup/P26_cranial_arch_mid.stl
148.0 x 76.8 x 8.00
