Iwetter/Mimic-Animatronic-Head/variants/r4-m3-retrofit/STL_REPRINT/P07_eye_horn_sandwich_PRINT_1.stl

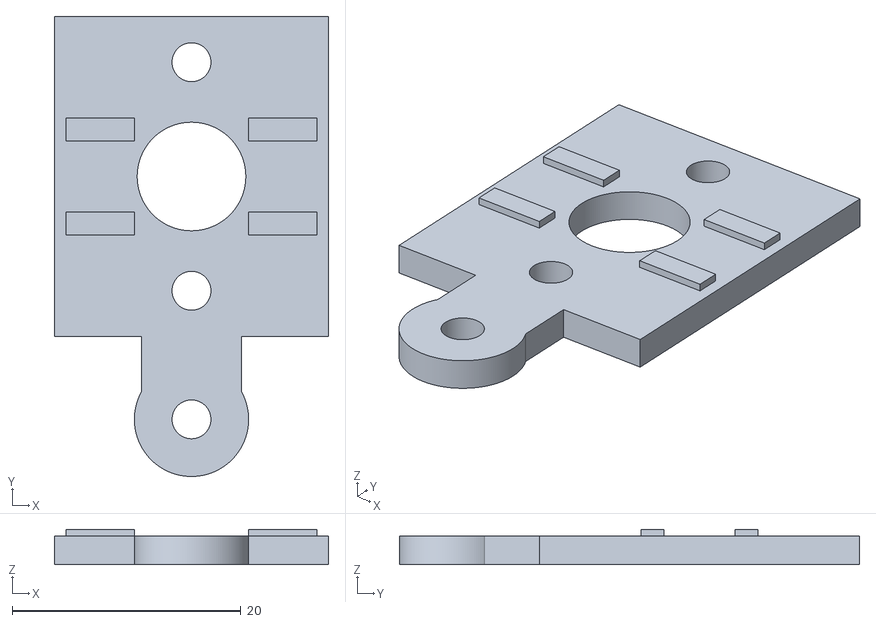
[picture p58: CAD file, 2026-11-07]
variants/r4-m3-retrofit/STL_REPRINT/P07_eye_horn_sandwich_PRINT_1.stl
24.0 x 40.2 x 3.10
