Iwetter/Mimic-Animatronic-Head/stl_backup/P46_eye_pitch_pushrod.stl

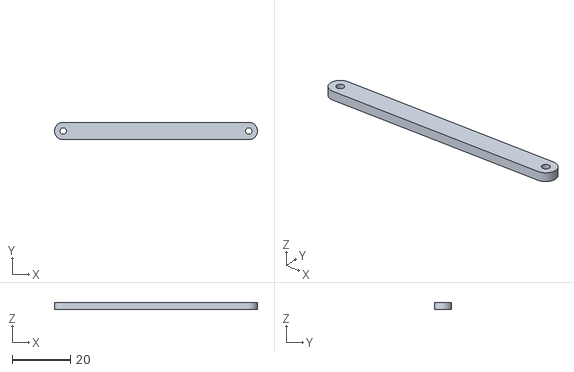
[picture p59: CAD file, 2026-10-22]
stl_backup/P46_eye_pitch_pushrod.stl
70.0 x 6.00 x 2.50
