Iwetter/Mimic-Animatronic-Head/variants/r4-m3-retrofit/assembly_meshes/servo_jaw.stl

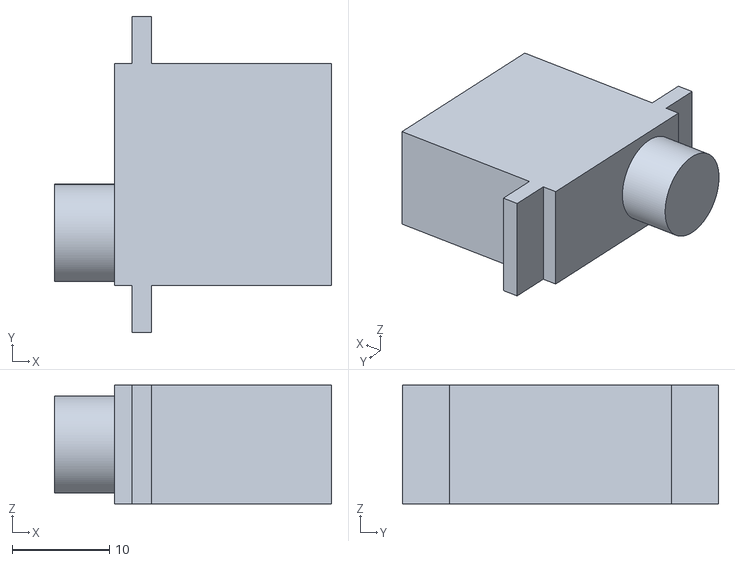
[picture p60: CAD file, 2026-11-07]
variants/r4-m3-retrofit/assembly_meshes/servo_jaw.stl
28.5 x 32.5 x 12.2
