Iwetter/Mimic-Animatronic-Head/variants/r4-m3-retrofit/reference_R4/STEP/parts/P12_skeletal_brow_and_upper_teeth.step

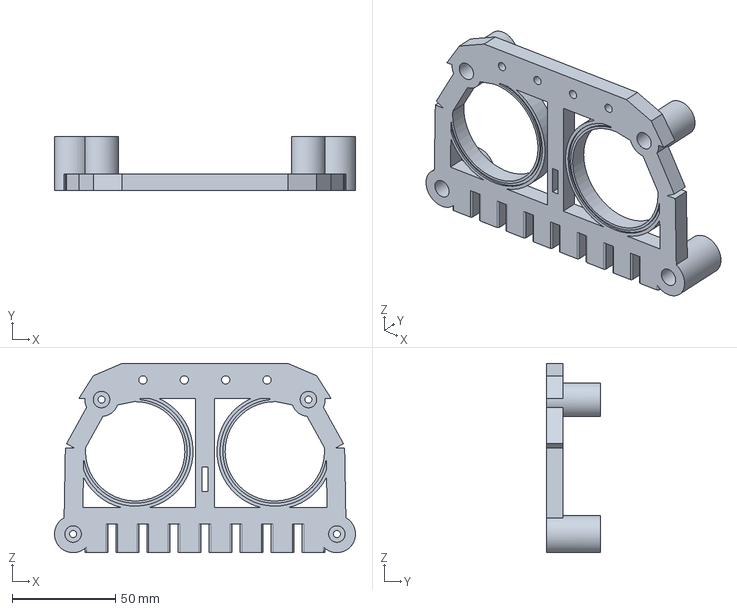
[picture p61: CAD file, 2026-11-07]
variants/r4-m3-retrofit/reference_R4/STEP/parts/P12_skeletal_brow_and_upper_teeth.step
145.5 x 26.2 x 91.5 mm
