Iwetter/Mimic-Animatronic-Head/stl_backup/P45_common_pitch_carrier.stl

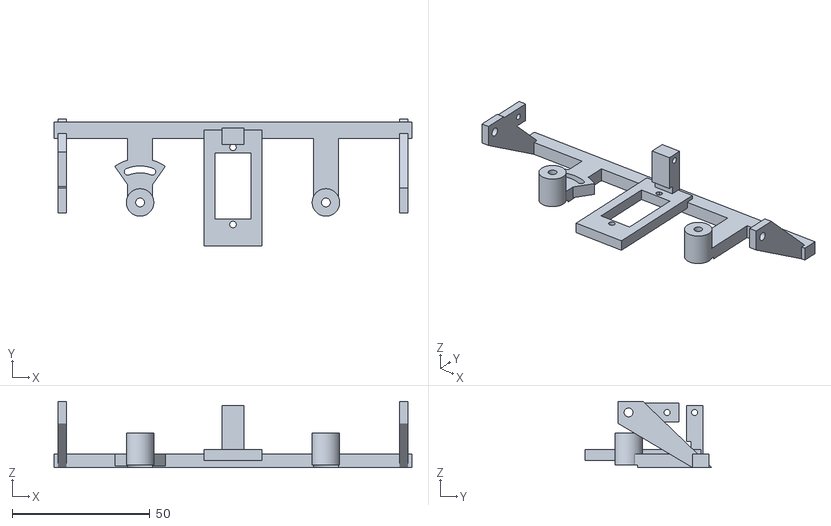
[picture p62: CAD file, 2026-10-22]
stl_backup/P45_common_pitch_carrier.stl
130.0 x 46.0 x 24.0
