Iwetter/Mimic-Animatronic-Head/variants/r4-m3-retrofit/reference_R4/STEP/parts/P00_PRINT_FIRST_fit_coupon.step

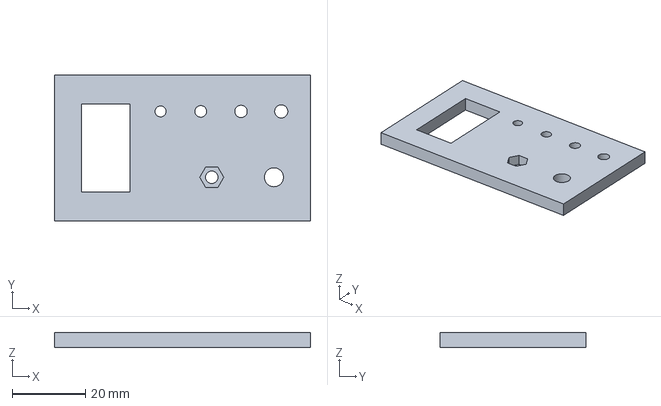
[picture p63: CAD file, 2026-11-07]
variants/r4-m3-retrofit/reference_R4/STEP/parts/P00_PRINT_FIRST_fit_coupon.step
70.0 x 40.0 x 4.00 mm
