Iwetter/Mimic-Animatronic-Head/variants/r4-m3-retrofit/STL_REPRINT/P06_M3_eye_link_PRINT_1.stl

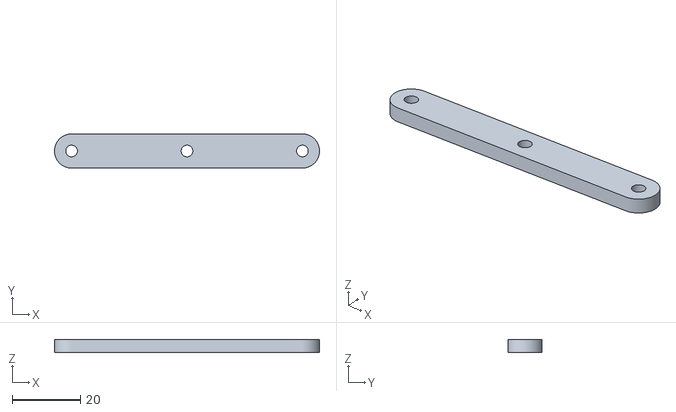
[picture p64: CAD file, 2026-11-07]
variants/r4-m3-retrofit/STL_REPRINT/P06_M3_eye_link_PRINT_1.stl
77.5 x 10.0 x 3.75
