Iwetter/Mimic-Animatronic-Head/stl_backup/P37_yaw_crank.stl

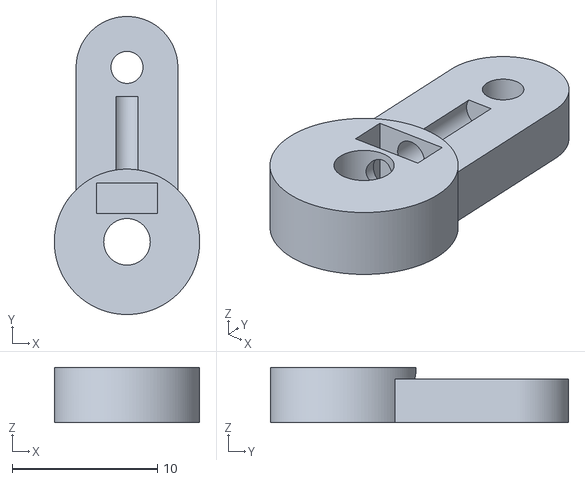
[picture p65: CAD file, 2026-10-22]
stl_backup/P37_yaw_crank.stl
10.0 x 20.5 x 3.80
