Iwetter/Mimic-Animatronic-Head/stl_backup/P23_upper_cranial_plate_L.stl

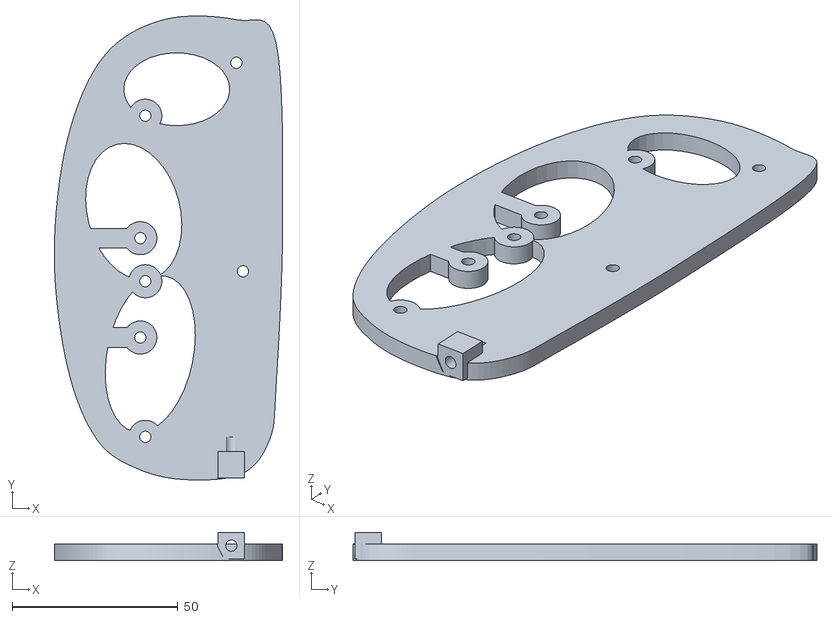
[picture p66: CAD file, 2026-10-22]
stl_backup/P23_upper_cranial_plate_L.stl
69.0 x 140.2 x 8.50
