Iwetter/Mimic-Animatronic-Head/variants/r4-m3-retrofit/assembly_meshes/eye_pin_L85.stl

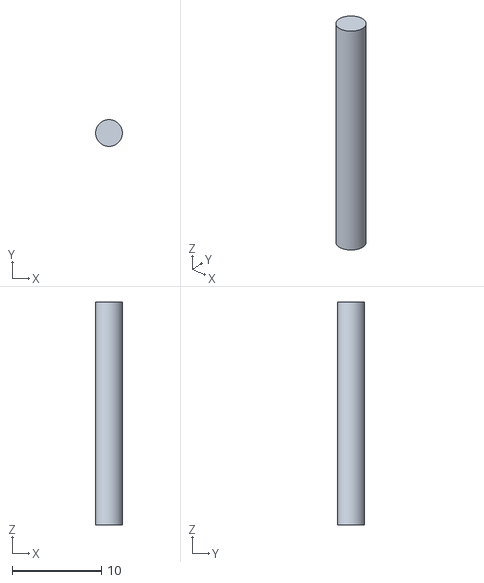
[picture p67: CAD file, 2026-11-07]
variants/r4-m3-retrofit/assembly_meshes/eye_pin_L85.stl
3.00 x 3.00 x 25.0
