Iwetter/Mimic-Animatronic-Head/stl_backup/P34_eye_globe.stl

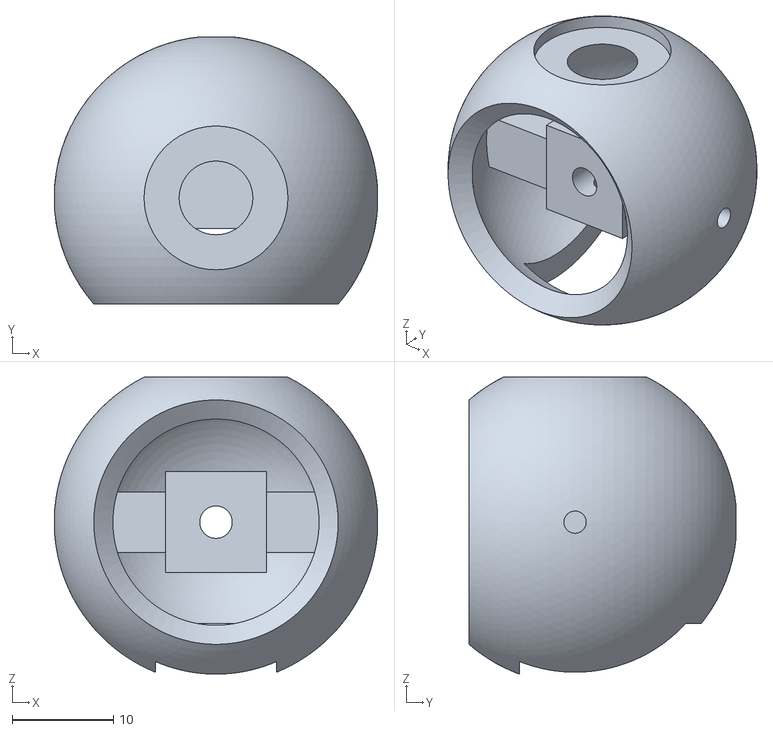
[picture p68: CAD file, 2026-10-22]
stl_backup/P34_eye_globe.stl
31.9 x 26.4 x 29.3
