Iwetter/Mimic-Animatronic-Head/variants/r4-m3-retrofit/reference_R4/STEP/parts/P08_jaw_left_drive_arm.step

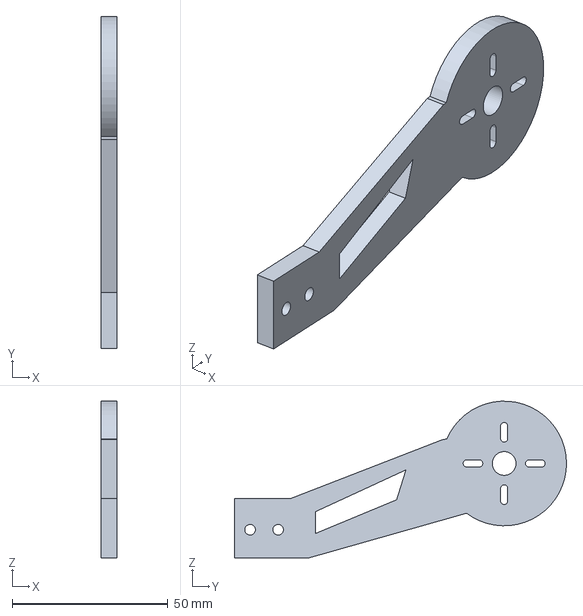
[picture p69: CAD file, 2026-11-07]
variants/r4-m3-retrofit/reference_R4/STEP/parts/P08_jaw_left_drive_arm.step
5.00 x 106.5 x 50.2 mm
