Iwetter/Mimic-Animatronic-Head/stl_backup/P42_upper_teeth_row.stl

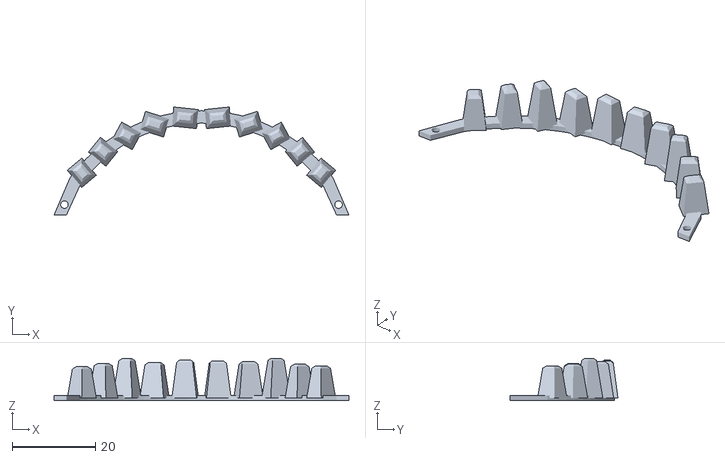
[picture p70: CAD file, 2026-10-22]
stl_backup/P42_upper_teeth_row.stl
71.0 x 26.0 x 10.2
