Iwetter/Mimic-Animatronic-Head/stl_backup/P32_maxilla_arch.stl

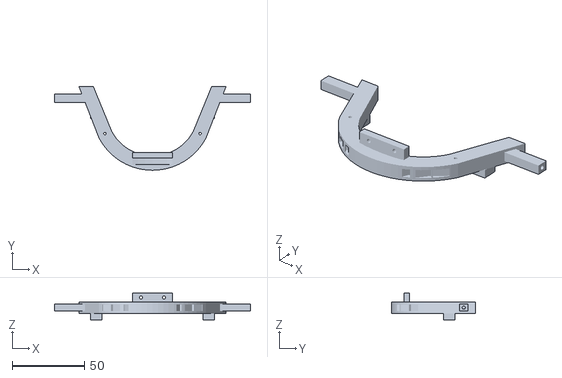
[picture p71: CAD file, 2026-10-22]
stl_backup/P32_maxilla_arch.stl
136.0 x 58.0 x 18.5
