Iwetter/Mimic-Animatronic-Head/stl_backup/P40_upper_lid_R.stl

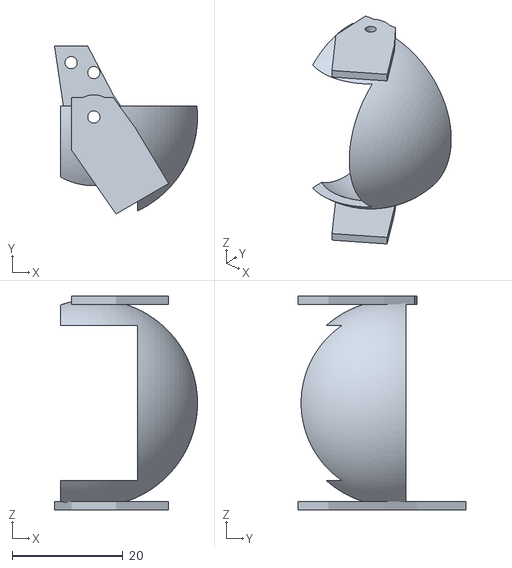
[picture p72: CAD file, 2026-10-22]
stl_backup/P40_upper_lid_R.stl
25.8 x 30.3 x 38.6
