Iwetter/Mimic-Animatronic-Head/stl_backup/P44_jaw_servo_cradle.stl

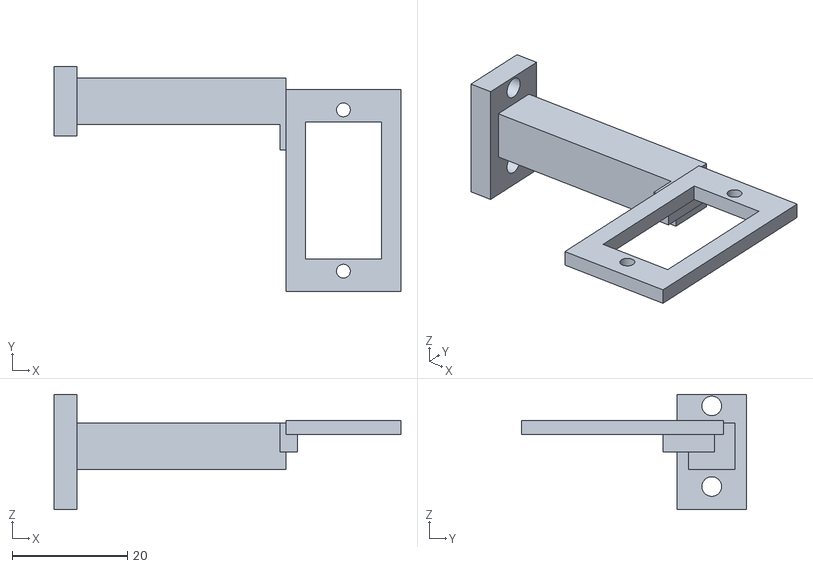
[picture p73: CAD file, 2026-10-22]
stl_backup/P44_jaw_servo_cradle.stl
60.2 x 39.0 x 20.0
