Iwetter/Mimic-Animatronic-Head/stl_backup/P29_face_mask.stl

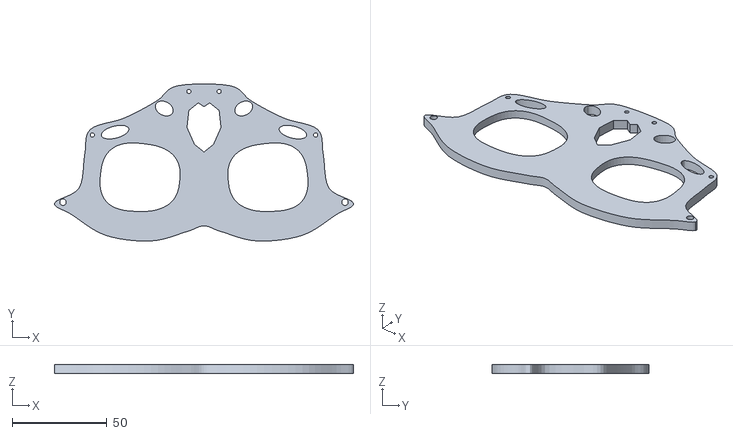
[picture p74: CAD file, 2026-10-22]
stl_backup/P29_face_mask.stl
158.0 x 83.1 x 4.50
