Iwetter/Mimic-Animatronic-Head/stl_backup/P22_lower_wall_R.stl

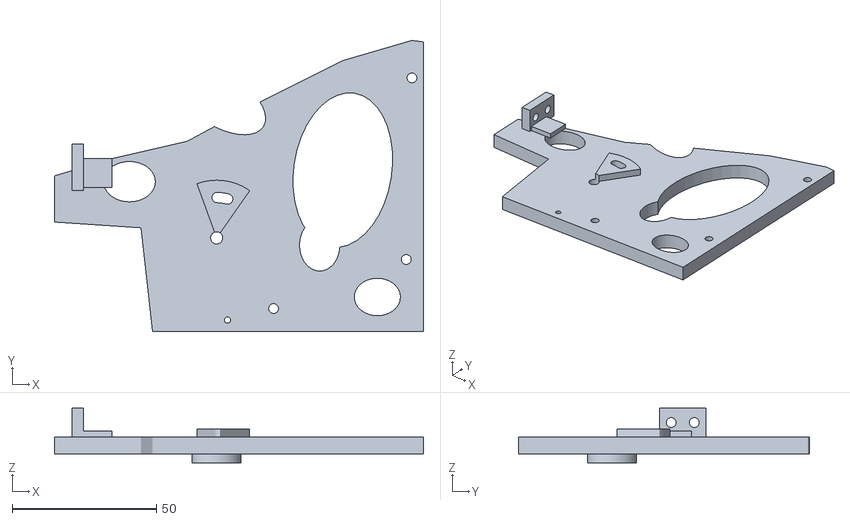
[picture p75: CAD file, 2026-10-22]
stl_backup/P22_lower_wall_R.stl
128.0 x 101.0 x 19.0
