Iwetter/Mimic-Animatronic-Head/stl_backup/P20_skull_base_plate.stl

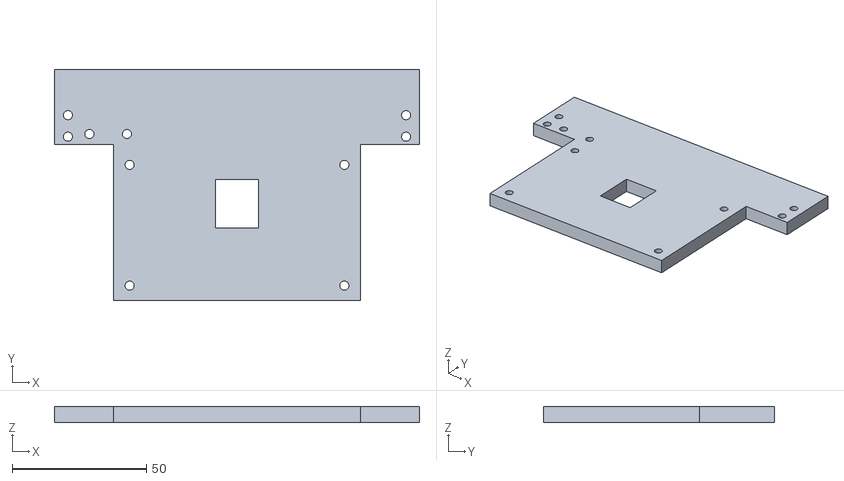
[picture p76: CAD file, 2026-10-22]
stl_backup/P20_skull_base_plate.stl
136.0 x 86.0 x 6.00
