Iwetter/Mimic-Animatronic-Head/stl_backup/P38_yaw_tie_half.stl

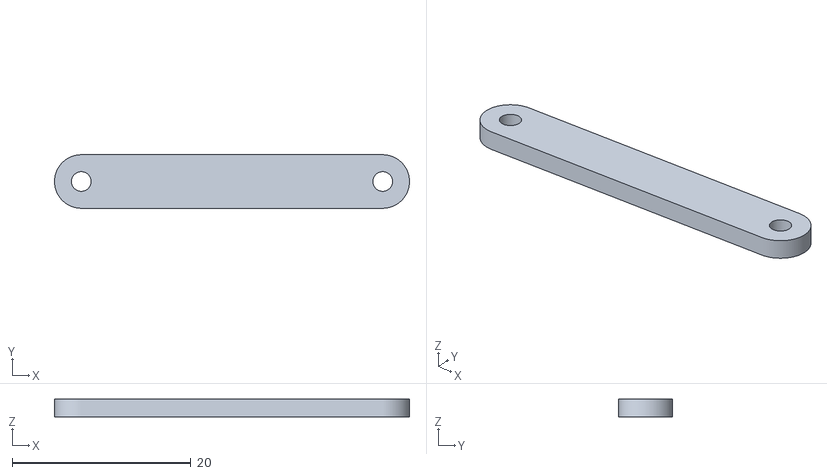
[picture p77: CAD file, 2026-10-22]
stl_backup/P38_yaw_tie_half.stl
39.7 x 6.00 x 2.00
