Iwetter/Mimic-Animatronic-Head/stl_backup/P36_eye_deck.stl

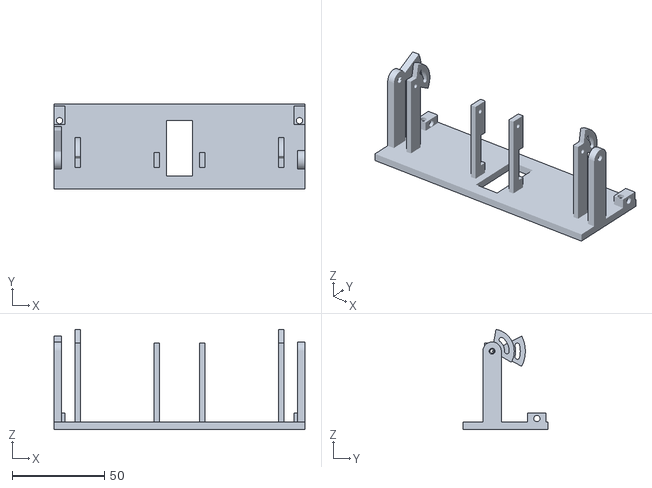
[picture p78: CAD file, 2026-10-22]
stl_backup/P36_eye_deck.stl
136.0 x 46.0 x 54.3
