Iwetter/Mimic-Animatronic-Head/stl_backup/P90_hardware_fit_coupon.stl

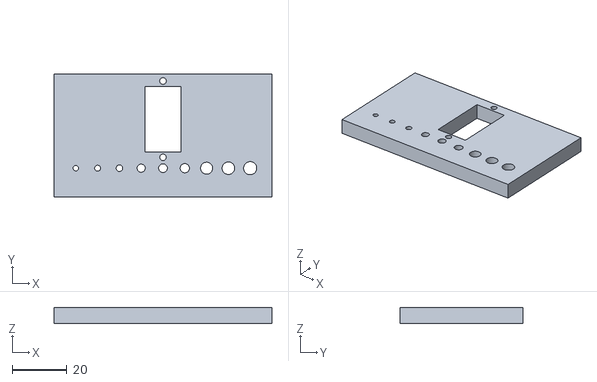
[picture p79: CAD file, 2026-10-22]
stl_backup/P90_hardware_fit_coupon.stl
80.0 x 45.0 x 6.00
