Iwetter/Mimic-Animatronic-Head/stl_backup/P43_lower_teeth_row.stl

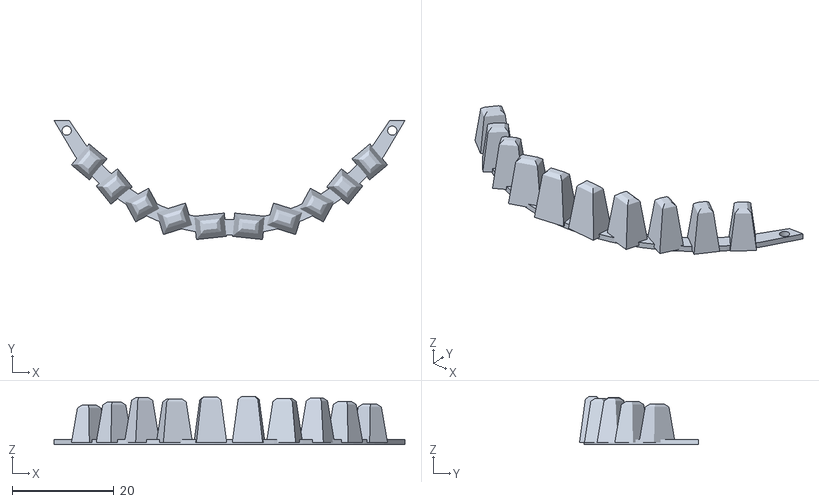
[picture p80: CAD file, 2026-10-22]
stl_backup/P43_lower_teeth_row.stl
69.0 x 23.4 x 9.50
