Iwetter/Mimic-Animatronic-Head/variants/r4-m3-retrofit/assembly_meshes/neck_nut(9, -48).stl

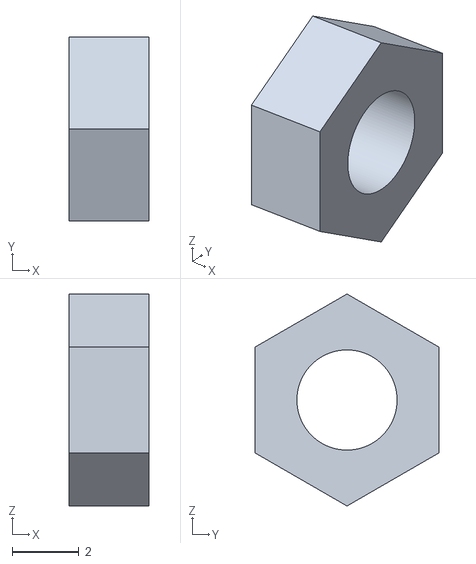
[picture p81: CAD file, 2026-11-07]
variants/r4-m3-retrofit/assembly_meshes/neck_nut(9, -48).stl
2.40 x 5.50 x 6.35
