Iwetter/Mimic-Animatronic-Head/stl_backup/P28_sagittal_crest.stl

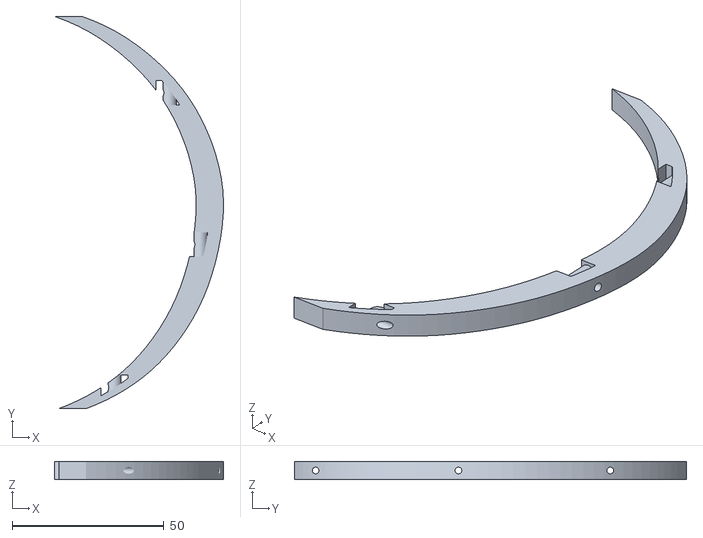
[picture p82: CAD file, 2026-10-22]
stl_backup/P28_sagittal_crest.stl
55.6 x 129.1 x 6.00
