Iwetter/Mimic-Animatronic-Head/stl_backup/P27_cranial_arch_rear.stl

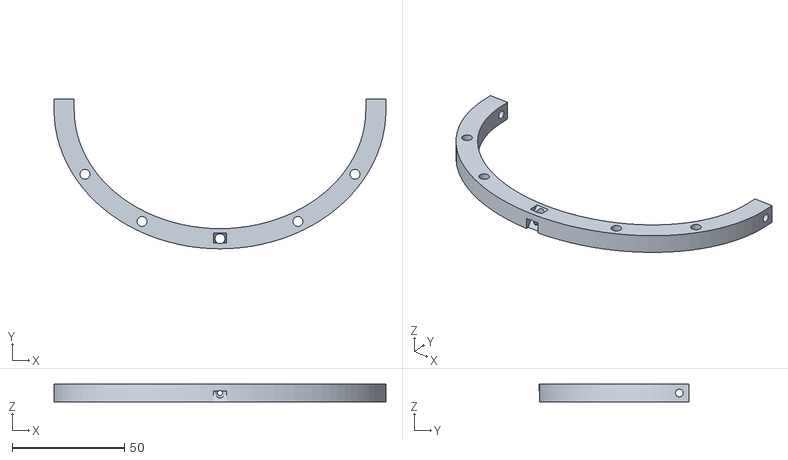
[picture p83: CAD file, 2026-10-22]
stl_backup/P27_cranial_arch_rear.stl
148.0 x 66.7 x 8.00
