Iwetter/Mimic-Animatronic-Head/variants/r4-m3-retrofit/assembly_meshes/A01_jaw_33.stl

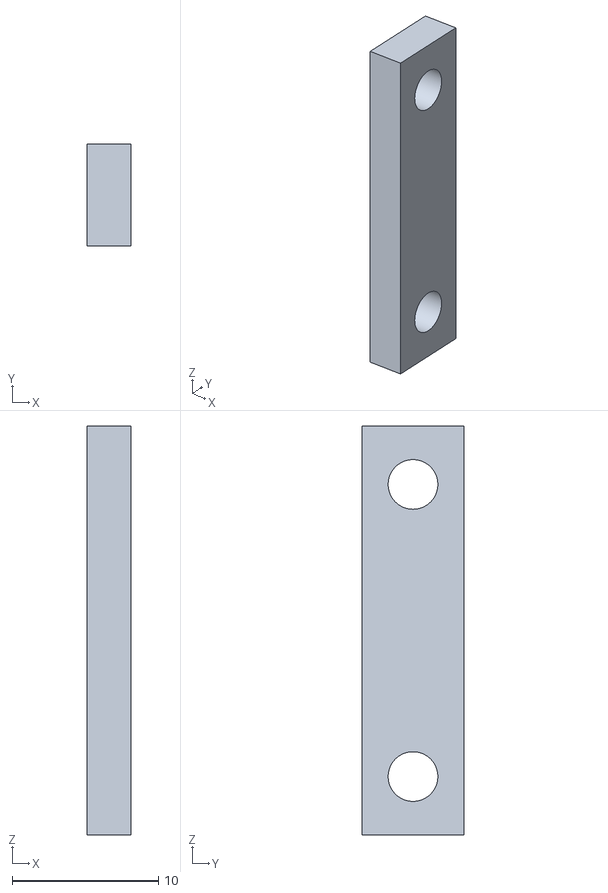
[picture p84: CAD file, 2026-11-07]
variants/r4-m3-retrofit/assembly_meshes/A01_jaw_33.stl
3.00 x 7.00 x 28.0
