Iwetter/Mimic-Animatronic-Head/variants/r4-m3-retrofit/assembly_meshes/link_pin_0.stl

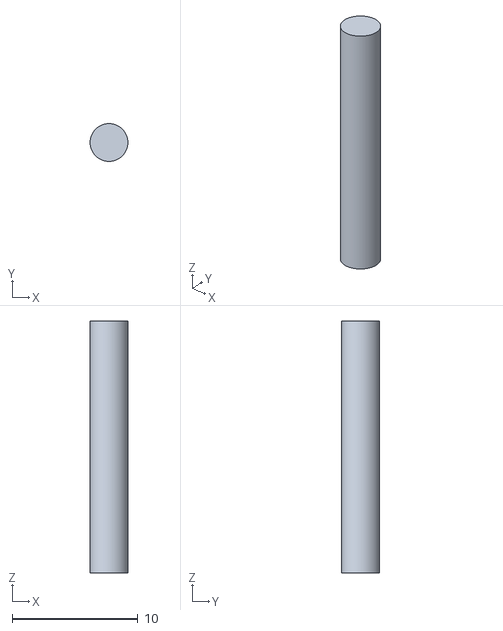
[picture p85: CAD file, 2026-11-07]
variants/r4-m3-retrofit/assembly_meshes/link_pin_0.stl
3.00 x 3.00 x 20.0
