Iwetter/Mimic-Animatronic-Head/variants/r4-m3-retrofit/assembly_meshes/OEM_jaw_horn.stl

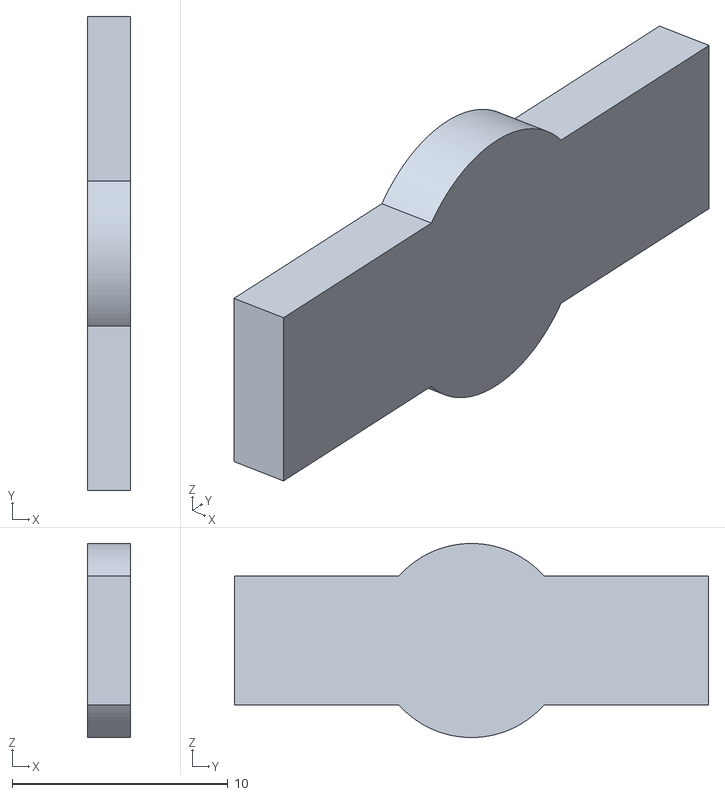
[picture p86: CAD file, 2026-11-07]
variants/r4-m3-retrofit/assembly_meshes/OEM_jaw_horn.stl
2.00 x 22.0 x 9.00
