Iwetter/Mimic-Animatronic-Head/variants/r4-m3-retrofit/assembly_meshes/P11_-33.75.stl

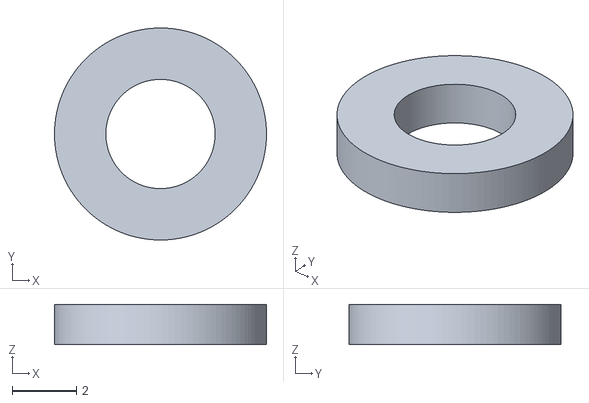
[picture p87: CAD file, 2026-11-07]
variants/r4-m3-retrofit/assembly_meshes/P11_-33.75.stl
6.60 x 6.60 x 1.25
