Iwetter/Mimic-Animatronic-Head/(list of files, cad)

Other CAD files:
variants/r4-m3-retrofit/STL_REPRINT/P08_jaw_horn_sandwich_PRINT_1.stl
variants/r4-m3-retrofit/STEP/T04_servo_tab_fit_bridge.step
variants/r4-m3-retrofit/STL_REPRINT/A03_jaw_servo_tab_bridge_PRINT_2.stl
variants/r4-m3-retrofit/FIT_TEST_FIRST/T04_servo_tab_fit_bridge_PRINT_1.stl
variants/r4-m3-retrofit/REUSED_R4_STL/P15_concentric_LED_iris.stl
variants/r4-m3-retrofit/assembly_meshes/P18.stl
variants/r4-m3-retrofit/STEP/A02_horn_clamp_plate.step
variants/r4-m3-retrofit/STL_REPRINT/A01_eye_servo_tab_bridge_PRINT_2.stl
variants/r4-m3-retrofit/reference_R4/STEP/parts/P05_large_eye_rotor.step
variants/r4-m3-retrofit/STEP/P06_M3_eye_link.step
variants/r4-m3-retrofit/PRINT_PLATES_3MF/02_FRAME.3mf
variants/r4-m3-retrofit/REUSED_R4_STL/P01_torso_spine_socket.stl
variants/r4-m3-retrofit/STEP/P08_jaw_horn_sandwich.step
variants/r4-m3-retrofit/STL_REPRINT/P10_eye_thrust_ring_PRINT_4.stl
variants/r4-m3-retrofit/reference_R4/STEP/parts/P19_lower_teeth_bridge.step
variants/r4-m3-retrofit/STEP/T02_horn_fit_lower.step
variants/r4-m3-retrofit/STEP/A03_jaw_servo_tab_bridge.step
variants/r4-m3-retrofit/STEP/T01_horn_fit_upper.step
variants/r4-m3-retrofit/assembly_meshes/P12.stl
variants/r4-m3-retrofit/STEP/P04_M3_clamp_frame.step
variants/r4-m3-retrofit/STL_REPRINT/P04_M3_clamp_frame_PRINT_1.stl
variants/r4-m3-retrofit/reference_R4/STEP/parts/P09_jaw_spacer.step
variants/r4-m3-retrofit/STEP/T03_servo_tab_fit_base.step
variants/r4-m3-retrofit/reference_R4/STEP/parts/P13_open_rear_cranium_truss.step
variants/r4-m3-retrofit/STEP/A01_eye_servo_tab_bridge.step
variants/r4-m3-retrofit/assembly_meshes/P05_L.stl
variants/r4-m3-retrofit/reference_R4/STEP/parts/P03_skeletal_neck_tenon.step
variants/r4-m3-retrofit/STEP/P07_eye_horn_sandwich.step
variants/r4-m3-retrofit/reference_R4/STEP/parts/P18_jaw_right_idler_arm.step
variants/r4-m3-retrofit/assembly_meshes/P15_R.stl
stl_backup/P39_upper_lid_L.stl
variants/r4-m3-retrofit/assembly_meshes/horn_jaw_head66.25.stl
variants/r4-m3-retrofit/assembly_meshes/P19.stl
stl_backup/P01_torso_spine_socket.stl
variants/r4-m3-retrofit/assembly_meshes/jaw_pivot_head.stl
variants/r4-m3-retrofit/assembly_meshes/eye_pin_head_L82.stl
stl_backup/P31_zygoma_R.stl
variants/r4-m3-retrofit/assembly_meshes/P10_L90.stl
variants/r4-m3-retrofit/assembly_meshes/jaw_mount_head_(33, 70.25).stl
stl_backup/P24_upper_cranial_plate_R.stl
variants/r4-m3-retrofit/assembly_meshes/eye_pin_head_R140.stl
stl_backup/P03_skeletal_neck_tenon.stl
variants/r4-m3-retrofit/assembly_meshes/jaw_mount_head_(4, 42.25).stl
variants/r4-m3-retrofit/assembly_meshes/neck_nut(-12.2, -38).stl
variants/r4-m3-retrofit/assembly_meshes/jaw_pivot_nut65.1.stl
variants/r4-m3-retrofit/assembly_meshes/eye_pin_head_L140.stl
variants/r4-m3-retrofit/assembly_meshes/horn_jaw_nut66.25.stl
variants/r4-m3-retrofit/assembly_meshes/jaw_mount_head_(4, 66.25).stl
variants/r4-m3-retrofit/assembly_meshes/P09.stl
variants/r4-m3-retrofit/assembly_meshes/jaw_mount_head_(33, 46.25).stl
variants/r4-m3-retrofit/assembly_meshes/P10_R90.stl
variants/r4-m3-retrofit/assembly_meshes/eye_mount_head_(-10, -36).stl
variants/r4-m3-retrofit/assembly_meshes/neck_nut(-12.2, -48).stl
variants/r4-m3-retrofit/assembly_meshes/eye_mount_head_(-10, -7).stl
variants/r4-m3-retrofit/assembly_meshes/jaw_mount_head_(33, 42.25).stl
variants/r4-m3-retrofit/assembly_meshes/P15_L.stl
variants/r4-m3-retrofit/assembly_meshes/A01_jaw_4.stl
variants/r4-m3-retrofit/assembly_meshes/neck_head(-22, -38).stl
variants/r4-m3-retrofit/assembly_meshes/OEM_eye_horn.stl
variants/r4-m3-retrofit/assembly_meshes/P07.stl
variants/r4-m3-retrofit/assembly_meshes/P13.stl
variants/r4-m3-retrofit/assembly_meshes/neck_head(19, -38).stl
variants/r4-m3-retrofit/assembly_meshes/link_pin_-33.75.stl
variants/r4-m3-retrofit/assembly_meshes/A03_jaw_33.stl
variants/r4-m3-retrofit/assembly_meshes/P01.stl
variants/r4-m3-retrofit/assembly_meshes/eye_pin_L115.stl
variants/r4-m3-retrofit/assembly_meshes/P03.stl
variants/r4-m3-retrofit/assembly_meshes/horn_jaw_head46.25.stl
variants/r4-m3-retrofit/assembly_meshes/P10_R134.stl
variants/r4-m3-retrofit/assembly_meshes/link_head_-33.75.stl
variants/r4-m3-retrofit/assembly_meshes/horn_eye_head-17.5.stl
variants/r4-m3-retrofit/assembly_meshes/horn_jaw_nut46.25.stl
variants/r4-m3-retrofit/assembly_meshes/P04.stl
variants/r4-m3-retrofit/assembly_meshes/neck_head(19, -48).stl
variants/r4-m3-retrofit/assembly_meshes/P08.stl
variants/r4-m3-retrofit/assembly_meshes/A01_eye_-7.stl
variants/r4-m3-retrofit/assembly_meshes/servo_eye.stl
variants/r4-m3-retrofit/assembly_meshes/eye_pin_head_R82.stl
variants/r4-m3-retrofit/assembly_meshes/jaw_mount_head_(4, 46.25).stl
variants/r4-m3-retrofit/assembly_meshes/P11_0.stl
variants/r4-m3-retrofit/assembly_meshes/P10_L134.stl
variants/r4-m3-retrofit/assembly_meshes/A02_jaw.stl
variants/r4-m3-retrofit/assembly_meshes/eye_pin_R115.stl
variants/r4-m3-retrofit/assembly_meshes/neck_nut(9, -38).stl
variants/r4-m3-retrofit/assembly_meshes/horn_eye_head-37.5.stl
variants/r4-m3-retrofit/assembly_meshes/jaw_pivot_nut62.7.stl
cad_source/references/P01_torso_spine_socket.step
cad_source/references/P03_skeletal_neck_tenon.step
variants/r4-m3-retrofit/STEP/P03_short_bolt_neck.step
variants/r4-m3-retrofit/STEP/P11_M3_link_washer.step
variants/r4-m3-retrofit/STL_REPRINT/P03_short_bolt_neck_PRINT_1.stl
variants/r4-m3-retrofit/STL_REPRINT/P11_M3_link_washer_PRINT_3.stl
variants/r4-m3-retrofit/assembly_meshes/A02_eye.stl
variants/r4-m3-retrofit/assembly_meshes/P05_R.stl
variants/r4-m3-retrofit/assembly_meshes/P06.stl
variants/r4-m3-retrofit/assembly_meshes/P11_33.75.stl
variants/r4-m3-retrofit/assembly_meshes/eye_mount_head_(10, -36).stl
variants/r4-m3-retrofit/assembly_meshes/eye_mount_head_(10, -7).stl
variants/r4-m3-retrofit/assembly_meshes/eye_mount_nut_(-10, -36).stl
variants/r4-m3-retrofit/assembly_meshes/eye_mount_nut_(-10, -7).stl
variants/r4-m3-retrofit/assembly_meshes/eye_mount_nut_(10, -36).stl
variants/r4-m3-retrofit/assembly_meshes/eye_mount_nut_(10, -7).stl
variants/r4-m3-retrofit/assembly_meshes/eye_mount_screw_(-10, -36).stl
variants/r4-m3-retrofit/assembly_meshes/eye_mount_screw_(-10, -7).stl
variants/r4-m3-retrofit/assembly_meshes/eye_mount_screw_(10, -36).stl
variants/r4-m3-retrofit/assembly_meshes/eye_mount_screw_(10, -7).stl
variants/r4-m3-retrofit/assembly_meshes/eye_nut_L130.2.stl
variants/r4-m3-retrofit/assembly_meshes/eye_nut_L132.6.stl
variants/r4-m3-retrofit/assembly_meshes/eye_nut_L90.stl
variants/r4-m3-retrofit/assembly_meshes/eye_nut_L92.4.stl
variants/r4-m3-retrofit/assembly_meshes/eye_nut_R130.2.stl
variants/r4-m3-retrofit/assembly_meshes/eye_nut_R132.6.stl
variants/r4-m3-retrofit/assembly_meshes/eye_nut_R90.stl
variants/r4-m3-retrofit/assembly_meshes/eye_nut_R92.4.stl
variants/r4-m3-retrofit/assembly_meshes/eye_pin_R85.stl
variants/r4-m3-retrofit/assembly_meshes/horn_eye_nut-17.5.stl
variants/r4-m3-retrofit/assembly_meshes/horn_eye_nut-37.5.stl
variants/r4-m3-retrofit/assembly_meshes/horn_eye_screw-17.5.stl
variants/r4-m3-retrofit/assembly_meshes/horn_eye_screw-37.5.stl
variants/r4-m3-retrofit/assembly_meshes/horn_jaw_screw46.25.stl
variants/r4-m3-retrofit/assembly_meshes/horn_jaw_screw66.25.stl
variants/r4-m3-retrofit/assembly_meshes/jaw_mount_head_(33, 66.25).stl
variants/r4-m3-retrofit/assembly_meshes/jaw_mount_head_(4, 70.25).stl
variants/r4-m3-retrofit/assembly_meshes/jaw_mount_nut_(33, 42.25).stl
variants/r4-m3-retrofit/assembly_meshes/jaw_mount_nut_(33, 46.25).stl
variants/r4-m3-retrofit/assembly_meshes/jaw_mount_nut_(33, 66.25).stl
variants/r4-m3-retrofit/assembly_meshes/jaw_mount_nut_(33, 70.25).stl
variants/r4-m3-retrofit/assembly_meshes/jaw_mount_nut_(4, 42.25).stl
variants/r4-m3-retrofit/assembly_meshes/jaw_mount_nut_(4, 46.25).stl
variants/r4-m3-retrofit/assembly_meshes/jaw_mount_nut_(4, 66.25).stl
variants/r4-m3-retrofit/assembly_meshes/jaw_mount_nut_(4, 70.25).stl
variants/r4-m3-retrofit/assembly_meshes/jaw_mount_screw_(33, 42.25).stl
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
