Iwetter/Mimic-Animatronic-Head/renders/assembly_exploded.png

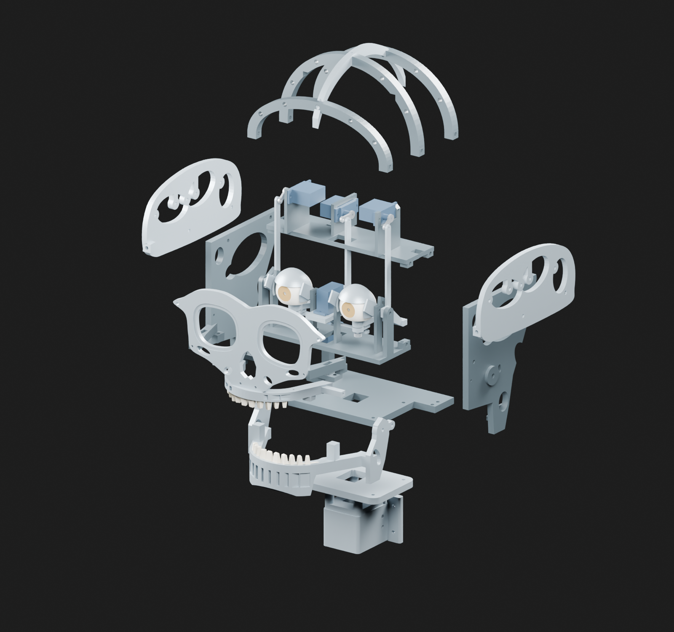
renders/assembly_exploded.png
