Iwetter/Mimic-Animatronic-Head/renders/assembly_front.png

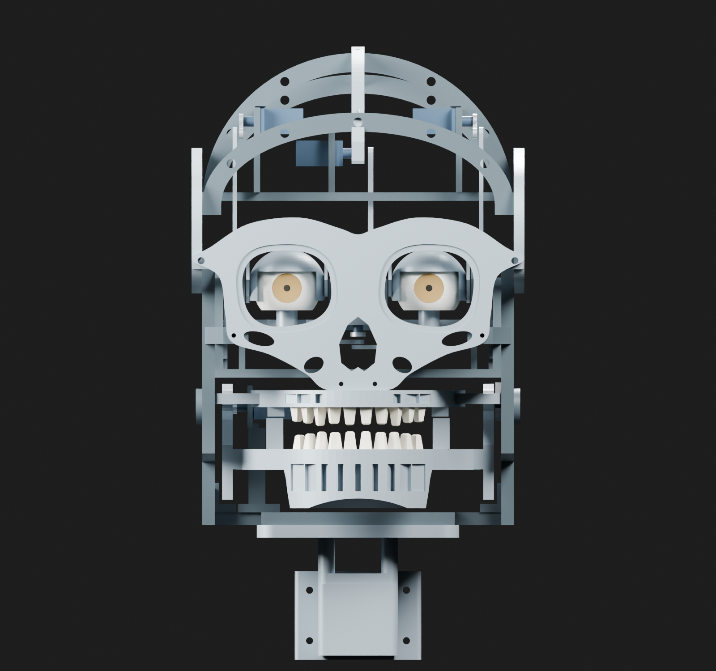
renders/assembly_front.png
