Iwetter/Mimic-Animatronic-Head/renders/assembly_side.png

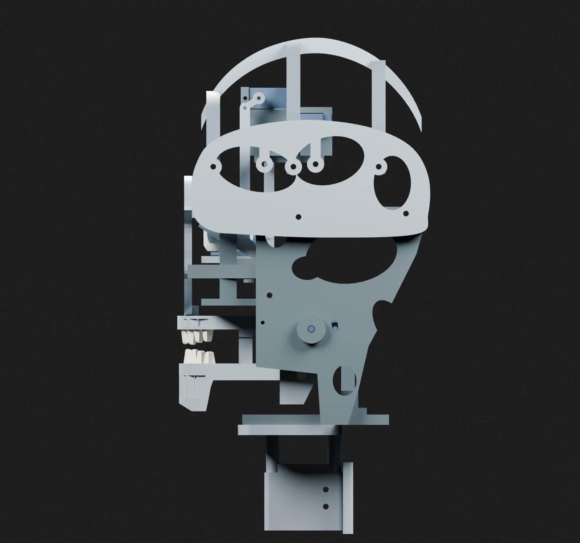
renders/assembly_side.png
