Iwetter/Mimic-Animatronic-Head/variants/r4-m3-retrofit/wiring/ESP32_PCA9685_wiring.png

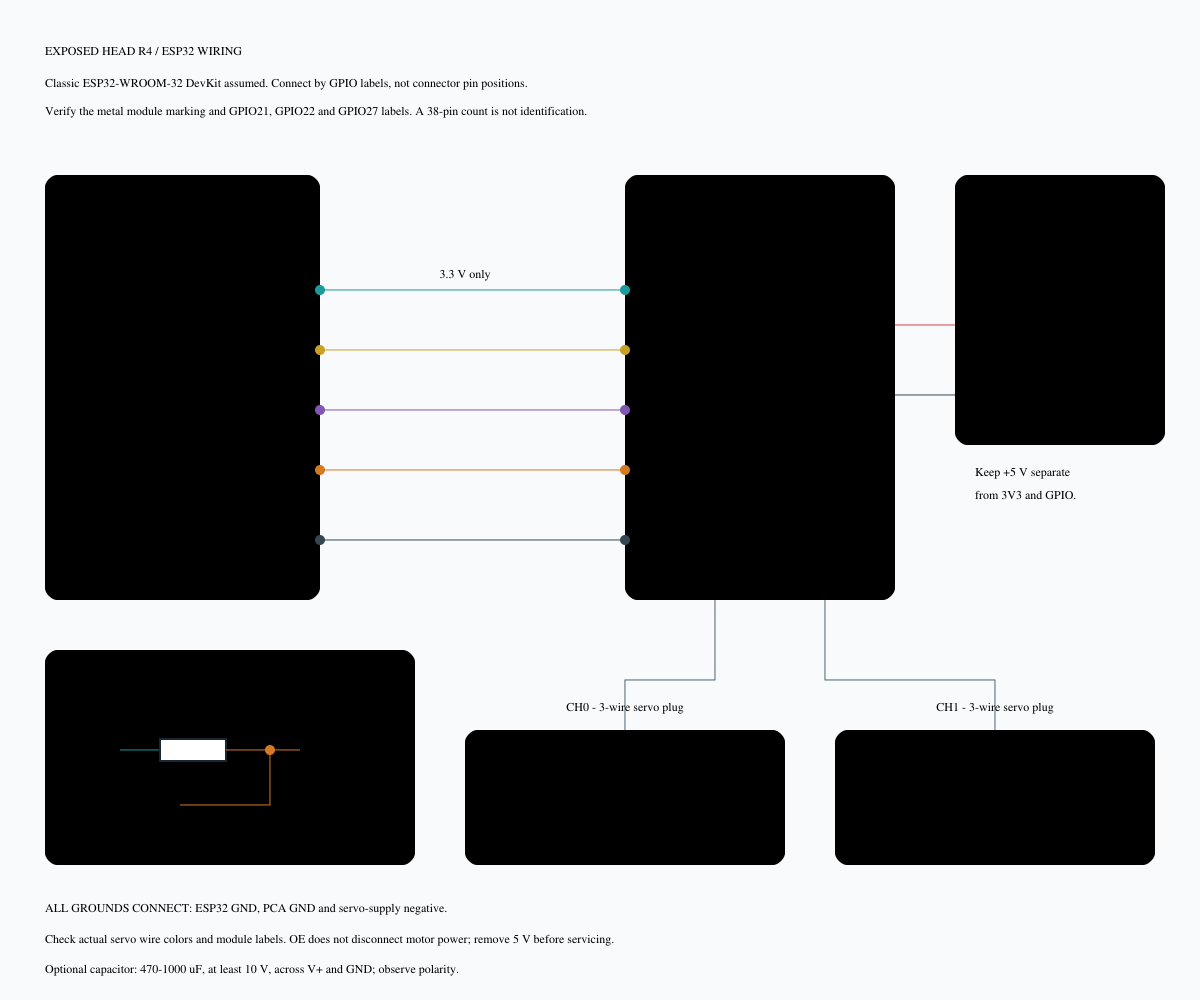
variants/r4-m3-retrofit/wiring/ESP32_PCA9685_wiring.png
