Iwetter/Mimic-Animatronic-Head/(commit log)

2026-10-22 Present engineering project with source, documentation, and validation context
    [P01_torso_spine_socket.step, P01_torso_spine_socket.stl, P03_skeletal_neck_tenon.step, P03_skeletal_neck_tenon.stl, P20_skull_base_plate.stl, P21_lower_wall_L.stl, P22_lower_wall_R.stl, P23_upper_cranial_plate_L.stl]
2026-11-07 Add R4 M3 retrofit print and assembly package
    [00_FIT_TEST_FIRST.3mf, 01_NECK.3mf, 02_FRAME.3mf, 03_EYES.3mf, 04_EYE_LINK.3mf, 05_LEFT_JAW.3mf, 06_CLAMPS.3mf, A01_eye_-36.stl]
2026-11-07 Illustrate R4 M3 retrofit changes and assembly
